TheZlodziej/keypad-board/kicad-project/ed_kicad_libraries/README.md

# Some of the most commonly used prefixes:
- C - capacitor
- D - diode (including LEDs!)
- J - header pins or 'jack' connector
- JP - jumper
- L - inductor
- M - motor
- Q - transistor/FETs
- R - resistor
- S - switch (TACT switch, etc.)
- TP - test point
- U - integrated circuit (sensors, MCUs, etc.)
- X - Wikipedia lists this last transducer, but it is often used to indicate connectors (USB, etc.)
- Y - Crystals or oscillators

> Source: https://learn.adafruit.com/ktowns-ultimate-creating-parts-in-eagle-tutorial/adding-a-name-prefix

Wrzucajcie źródła z któych korzystacie do sources, ale na schematch należy korzystać wyłącznie z naszych bilbilitek (prefix PUTRocketLab).
Chyba, że kopiujecie elementy z innych projektów eagle, do których nie dostępne są biblioteki.
