TheZlodziej/keypad-board/kicad-project/ed_kicad_libraries/Sources/BMM150_BGA_array.ods

 | x | y
E1 | -0.531 | 0.601
C1 | 0.035 | 0.601
A1 | 0.601 | 0.601
D2 | -0.248 | 0.318
B2 | 0.318 | 0.318
E3 | -0.531 | 0.035
A3 | 0.601 | 0.035
D4 | -0.248 | -0.248
B4 | 0.318 | -0.248
E5 | -0.531 | -0.531
C5 | 0.035 | -0.531
A5 | 0.601 | -0.531
