TheZlodziej/keypad-board/kicad-project/3d_models/asm_mx_asm_PLATE.stp

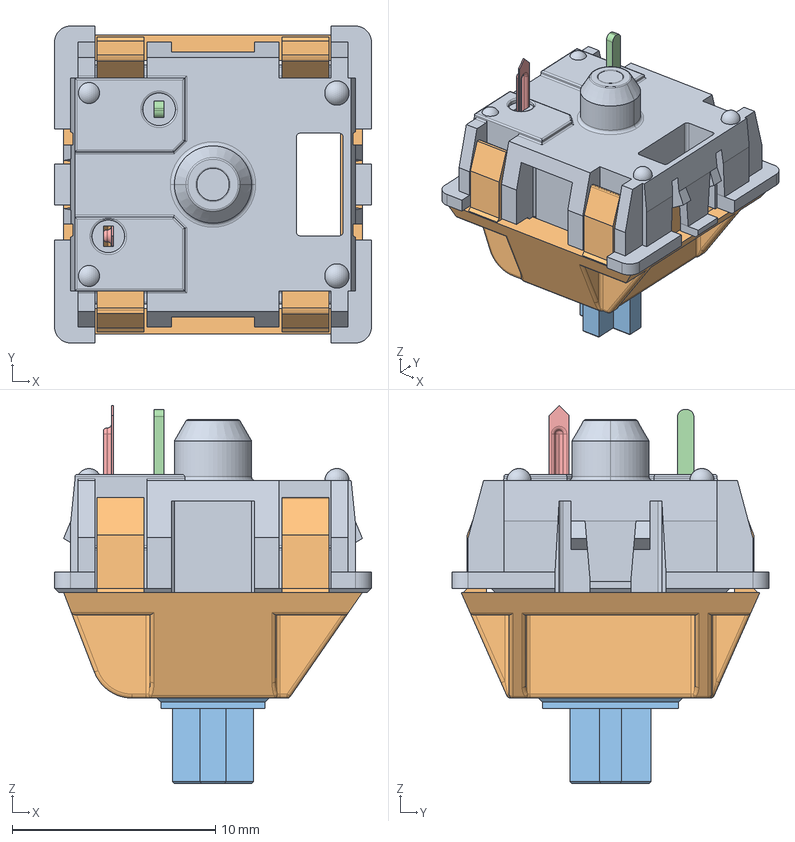
[picture p1: CAD file, 2023-11-23]
kicad-project/3d_models/asm_mx_asm_PLATE.stp
15.6 x 15.6 x 18.6 mm
MX_DOWN
MX_UP
UP_MX
MX_PIN
MX_SPRING
MX_CLICK
