TheZlodziej/keypad-board/kicad-project/3d_models/potentio_assem_asm.stp

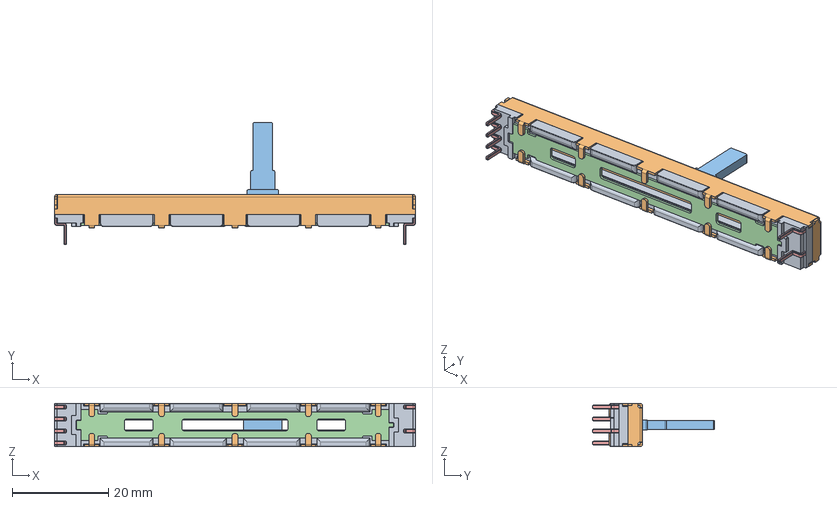
[picture p2: CAD file, 2023-11-23]
kicad-project/3d_models/potentio_assem_asm.stp
75.0 x 25.4 x 9.00 mm
SLIDE_POTENTIOMETER_BODY
SLIDE_POTENTIOMETER_COVER
SLIDE_POTENTIOMETER_BAR
SLIDE_POTENTIOMETER_PLATE
SLIDE_POTENTIOMETER_PIN x 6
