TheZlodziej/keypad-board/keypad-kicad-proj/keypad_cutout.dxf

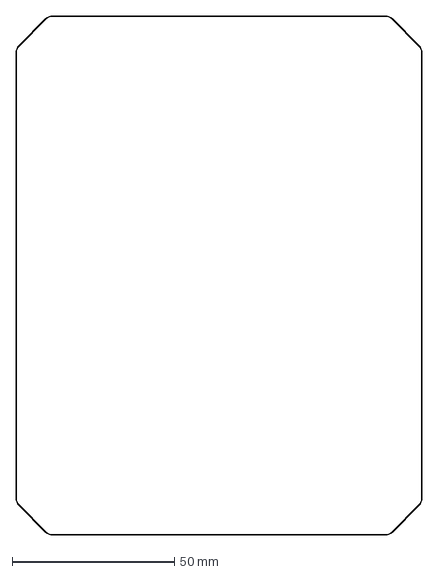
[picture p3: CAD file, 2023-11-23]
keypad-kicad-proj/keypad_cutout.dxf
125.0 x 160.0 mm
