TheZlodziej/keypad-board/kicad-project/ed_kicad_libraries/Sources/LIB_MAX-M10S-00B/MAX-M10S-00B/3D/MAX-M10S-00B.stp

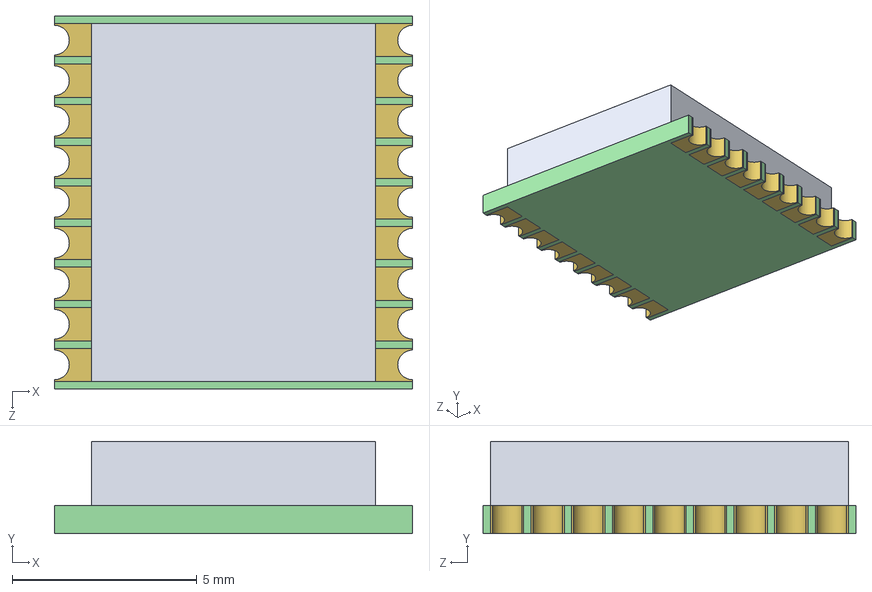
[picture p4: CAD file, 2023-11-23]
kicad-project/ed_kicad_libraries/Sources/LIB_MAX-M10S-00B/MAX-M10S-00B/3D/MAX-M10S-00B.stp
9.70 x 2.50 x 10.1 mm
