TheZlodziej/keypad-board/kicad-project/3d_models/Vertical slide switch SS-12D00G3 High Knob 3mm SPDT v2.step

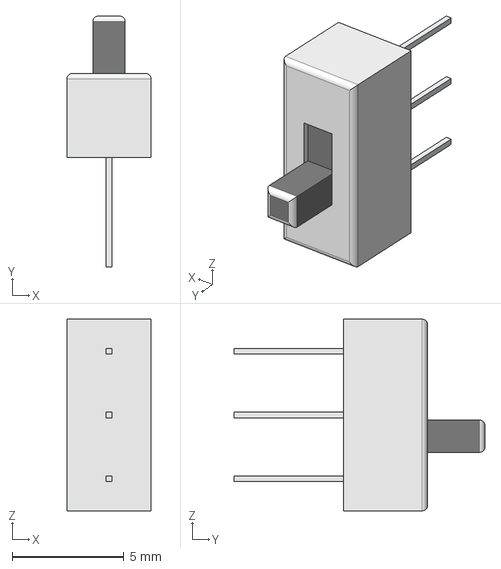
[picture p5: CAD file, 2023-11-23]
kicad-project/3d_models/Vertical slide switch SS-12D00G3 High Knob 3mm SPDT v2.step
3.77 x 11.2 x 8.59 mm
