TheZlodziej/keypad-board/kicad-project/3d_models/USB Type C Port (SMD Type).STEP

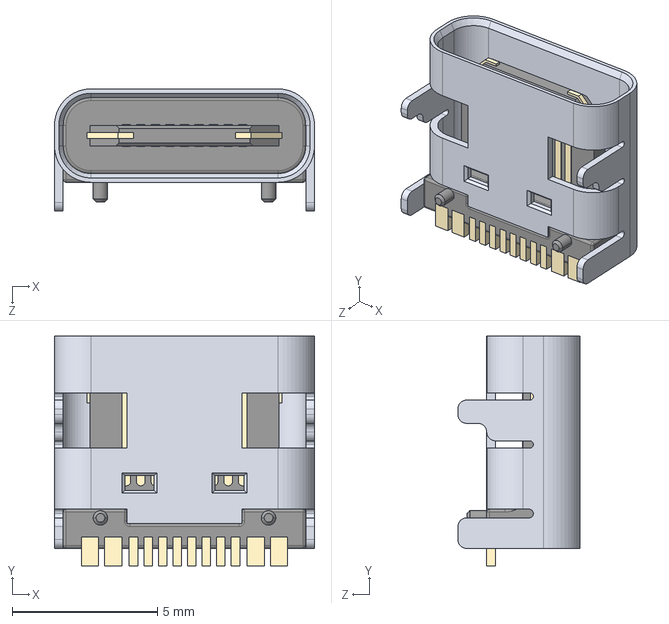
[picture p6: CAD file, 2023-11-23]
kicad-project/3d_models/USB Type C Port (SMD Type).STEP
8.94 x 7.90 x 4.20 mm
