TheZlodziej/keypad-board/kicad-project/3d_models/Buzzer_5V.STEP

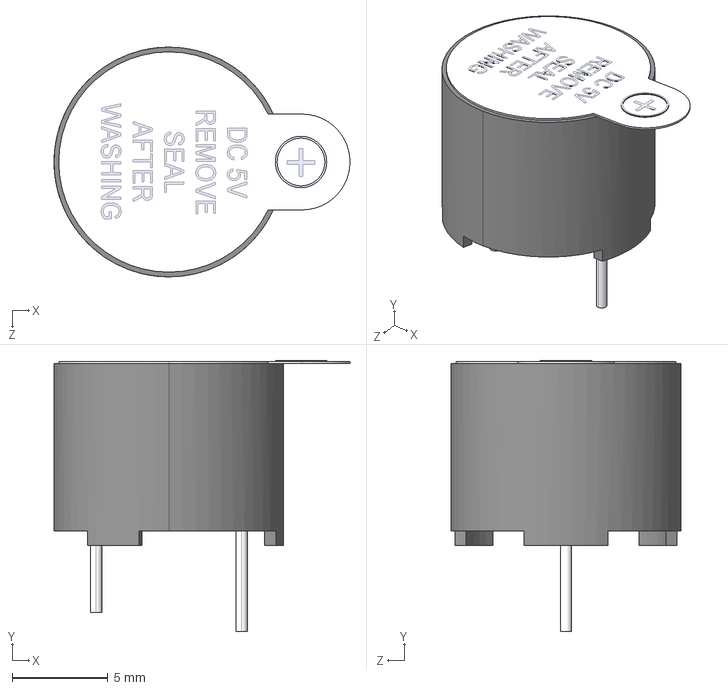
[picture p7: CAD file, 2023-11-23]
kicad-project/3d_models/Buzzer_5V.STEP
15.5 x 14.2 x 12.0 mm
