TheZlodziej/keypad-board/kicad-project/3d_models/Bourns_-_PEC11R-4220F-S0024.step

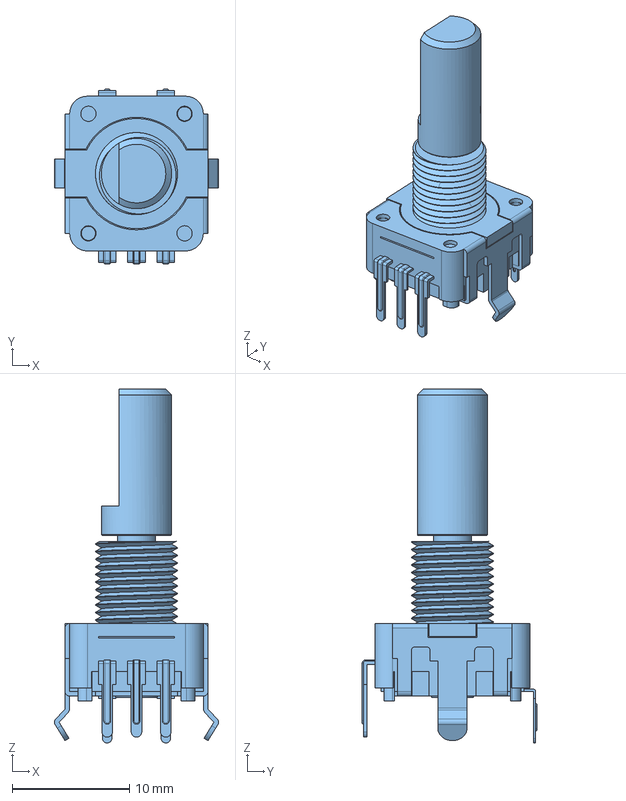
[picture p8: CAD file, 2023-11-23]
kicad-project/3d_models/Bourns_-_PEC11R-4220F-S0024.step
14.0 x 14.9 x 30.2 mm
