TheZlodziej/keypad-board/kicad-project/3d_models/mx_keycap.STEP

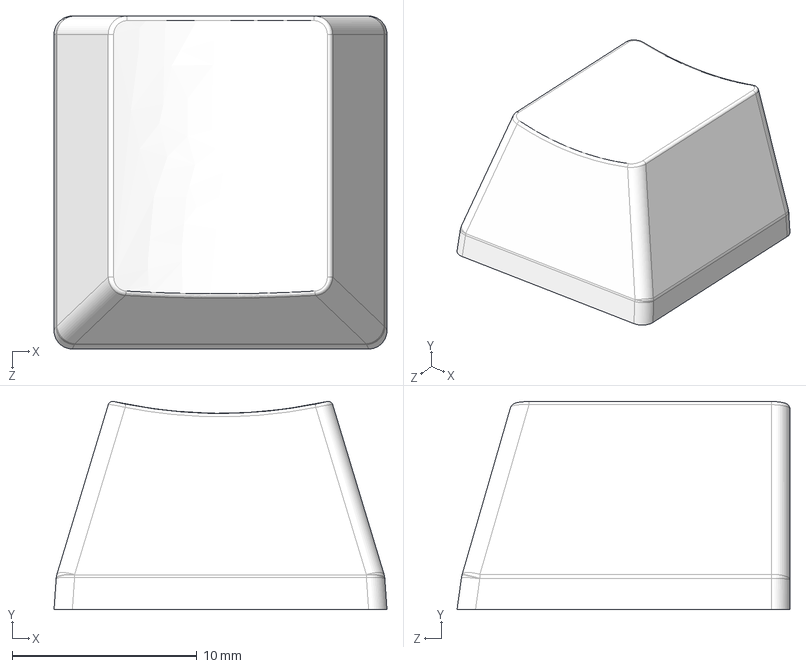
[picture p10: CAD file, 2023-11-23]
kicad-project/3d_models/mx_keycap.STEP
18.0 x 11.3 x 18.0 mm
