TheZlodziej/keypad-board/kicad-project/3d_models/EC12 Encoder 10mm 3pin.stp

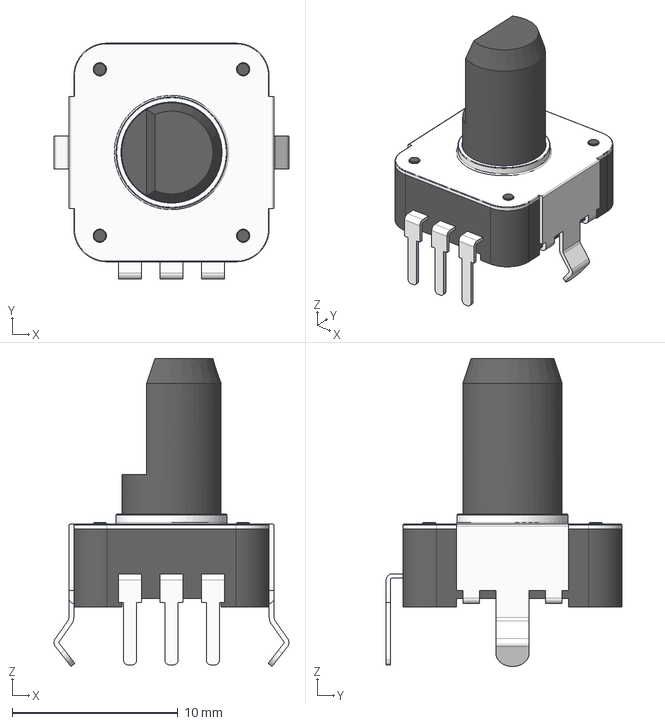
[picture p12: CAD file, 2023-11-23]
kicad-project/3d_models/EC12 Encoder 10mm 3pin.stp
14.2 x 14.2 x 18.6 mm
