TheZlodziej/keypad-board/(list of files, cad)

Other CAD files:
keypad-cover.ipt
kicad-project/ed_kicad_libraries/Sources/LIB_MAX-M10S-00B/MAX-M10S-00B/Allegro/maxm10s00b.psm
kicad-project/ed_kicad_libraries/Sources/LIB_MAX-M10S-00B/MAX-M10S-00B/DEHDL/max_m10s_00b/chips/chips.prt
