TheZlodziej/keypad-board/kicad-project/schematic.pdf

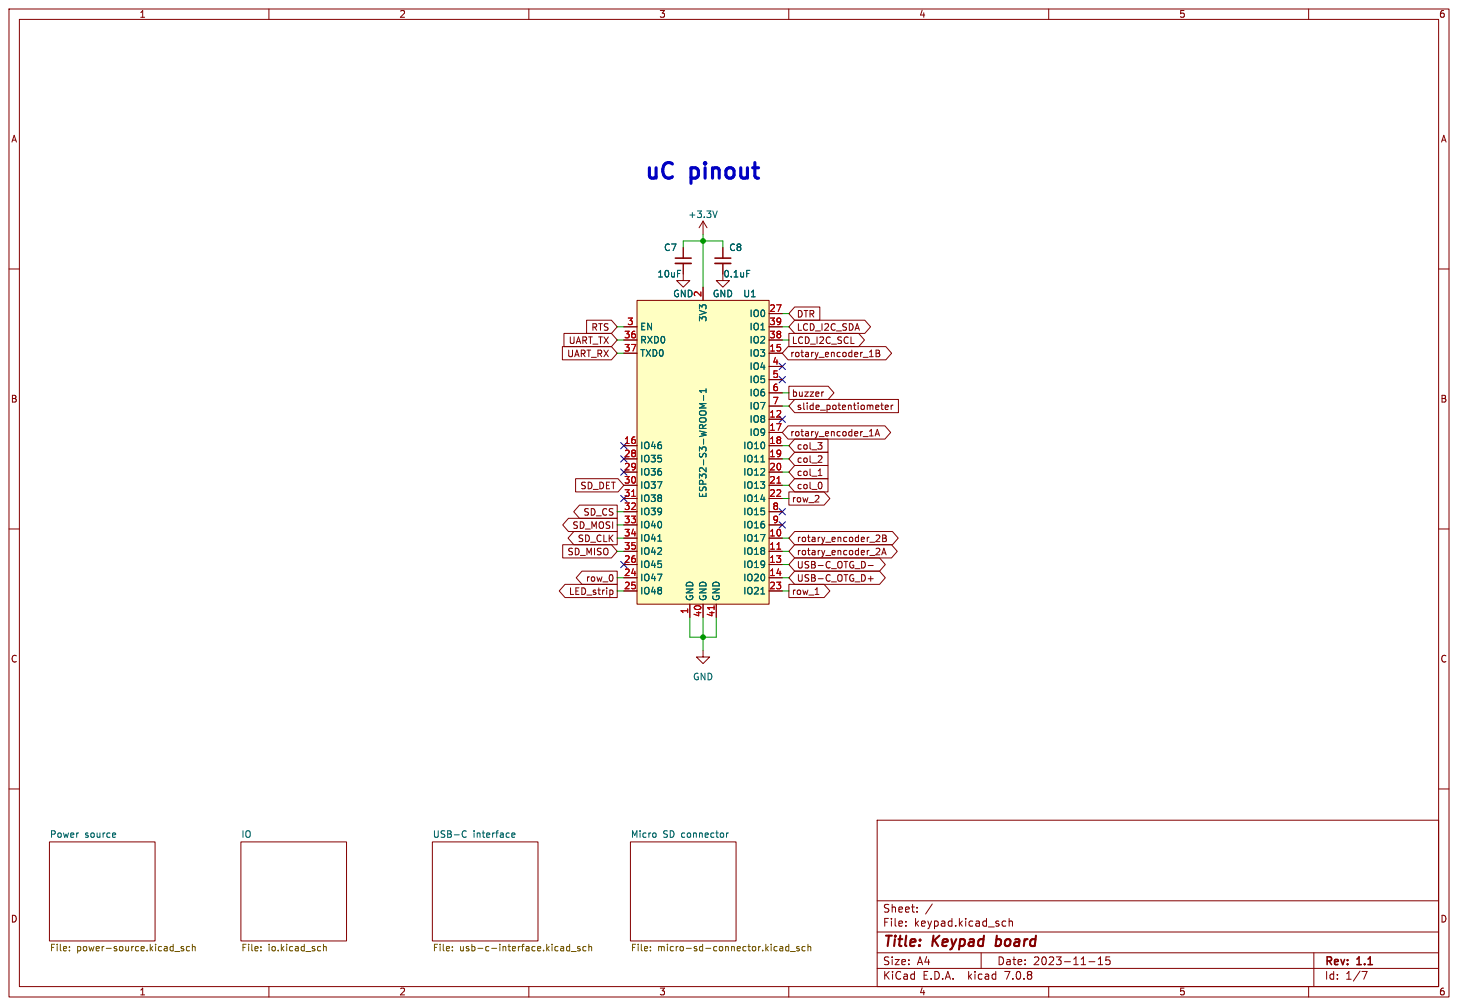
[picture p13: page 1]

File: keypad.kicad_sch Sheet: /
Id: 1/7 Title: Keypad board

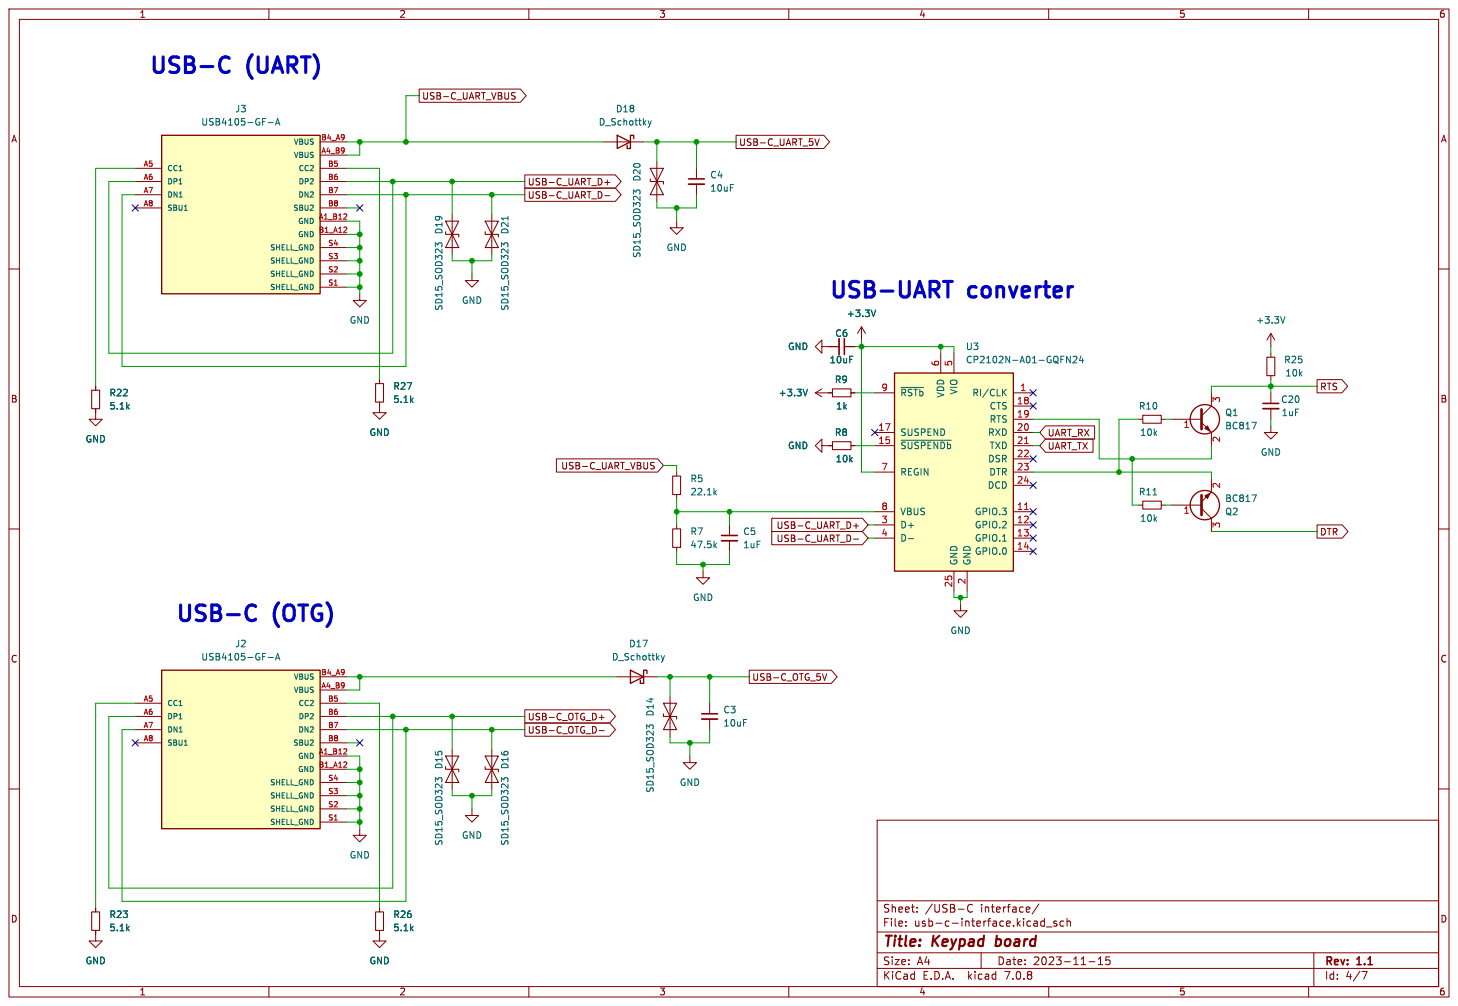
[picture p14: page 2]

2 RXD 20 TXD 21 DSR 22 DTR 23 DCD 24 GND 25 D+ 3 D- 4 VIO

Id: 4/7 Title: Keypad board

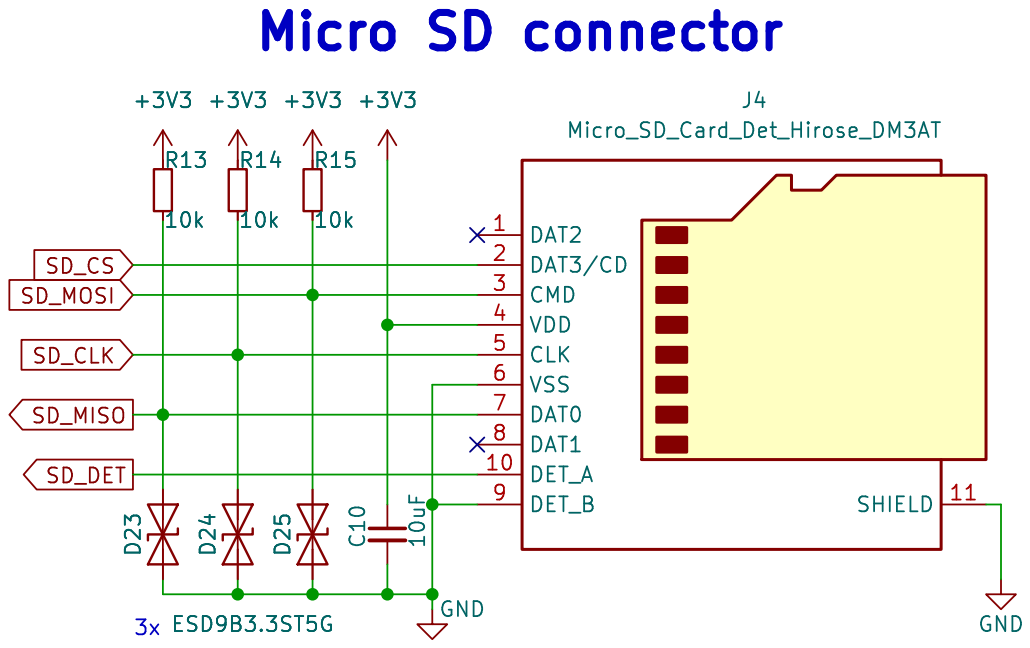
[picture p15: page 3]

Id: 5/7 Title: Keypad board

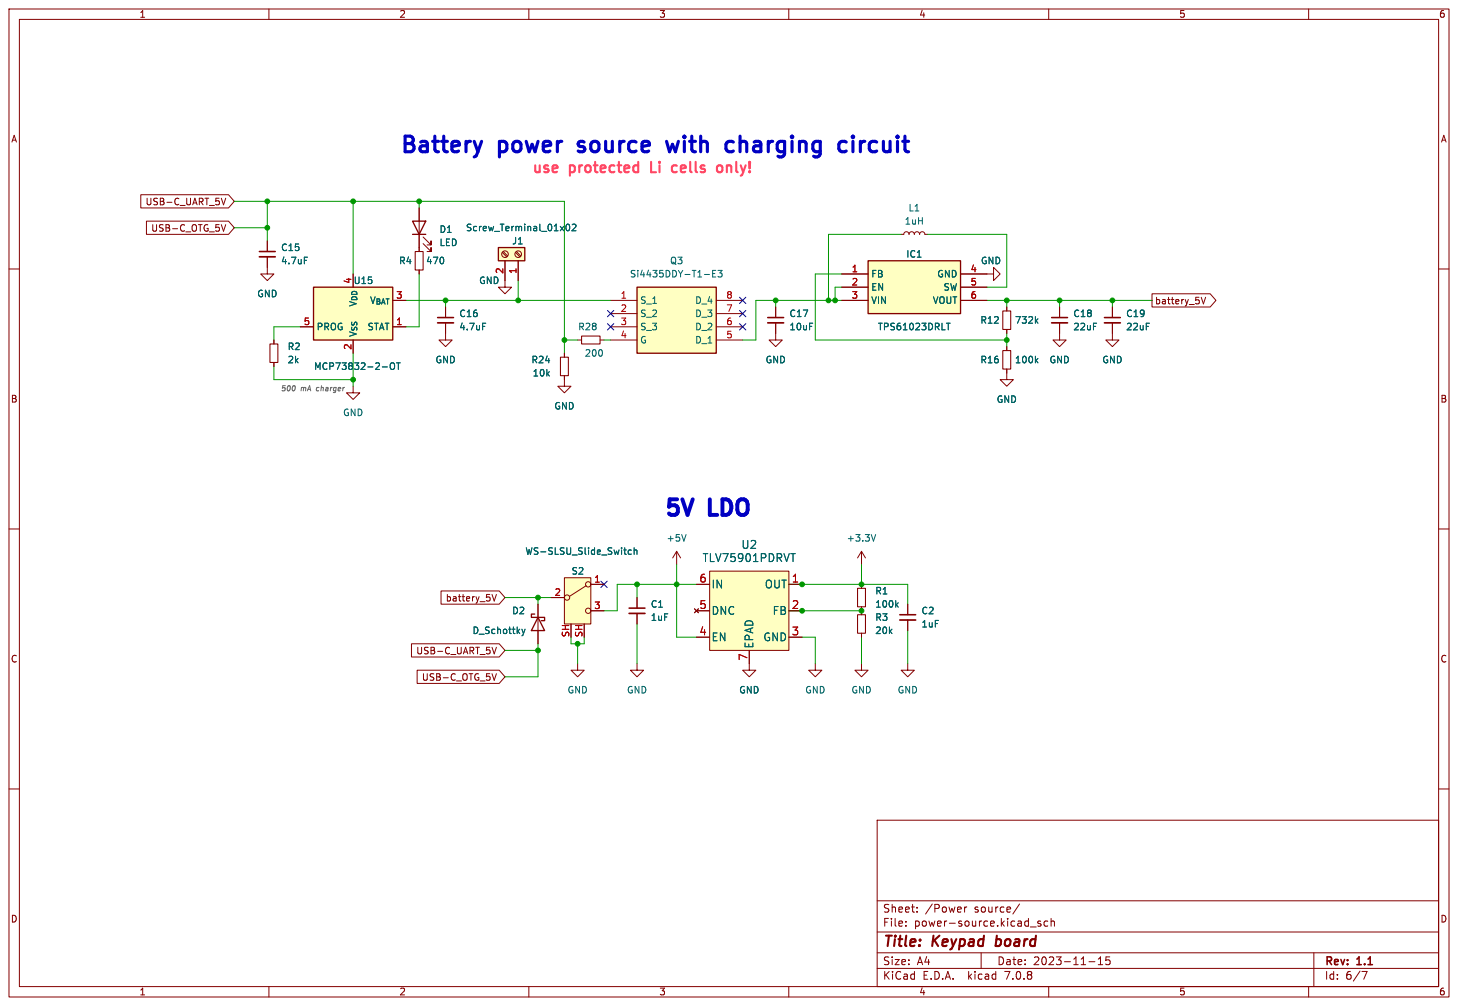
[picture p16: page 4]

Id: 6/7 Title: Keypad board

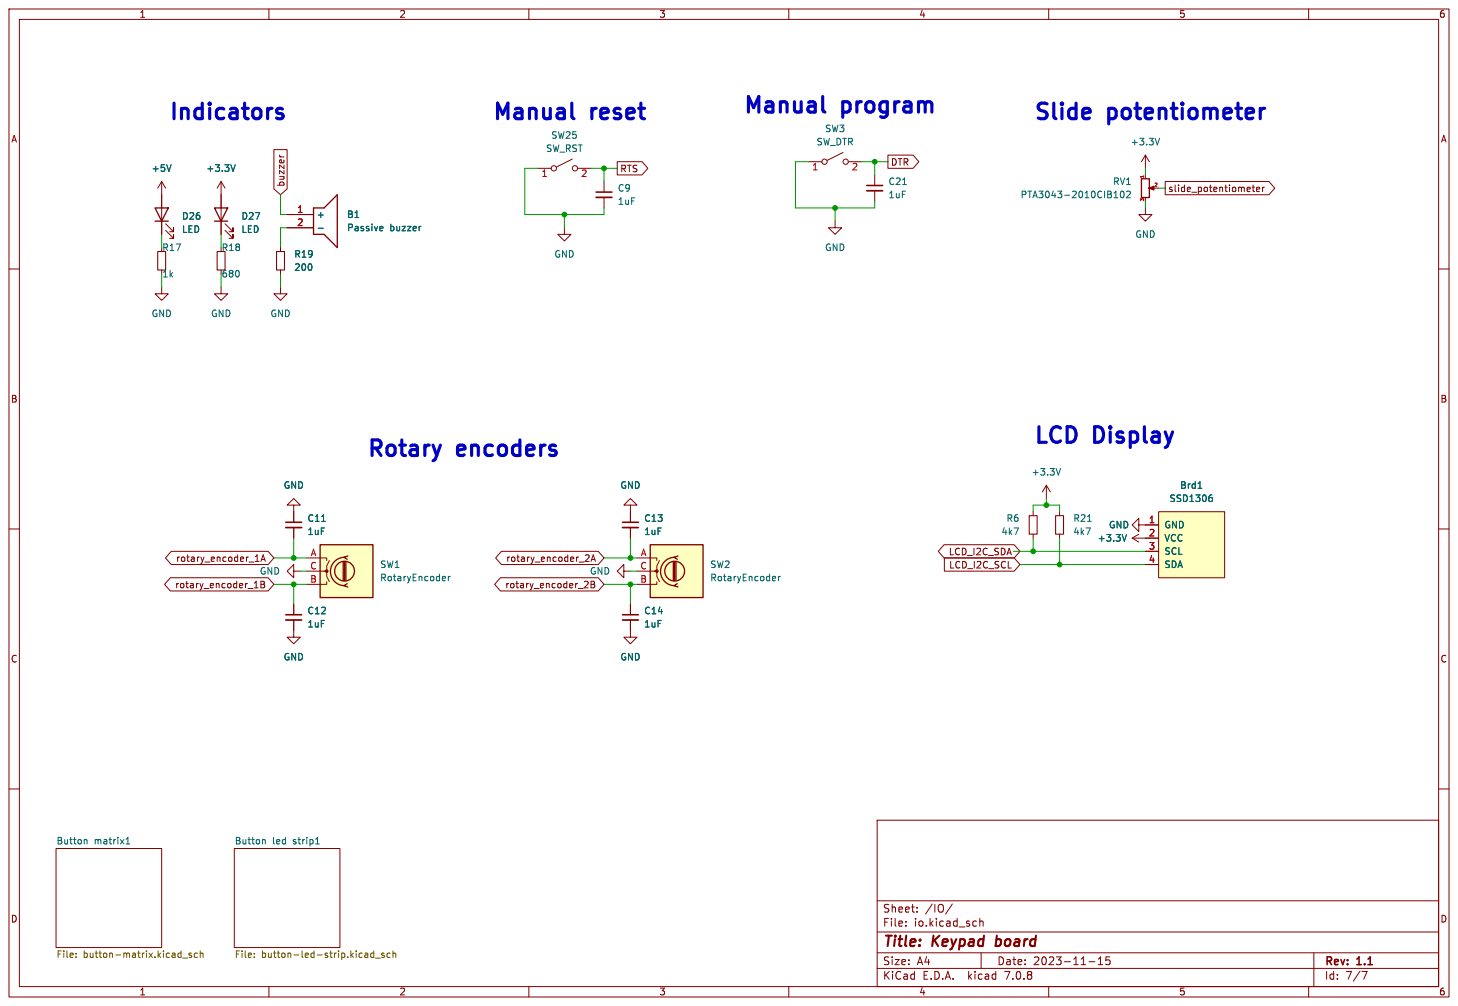
[picture p17: page 5]

Id: 7/7 Title: Keypad board

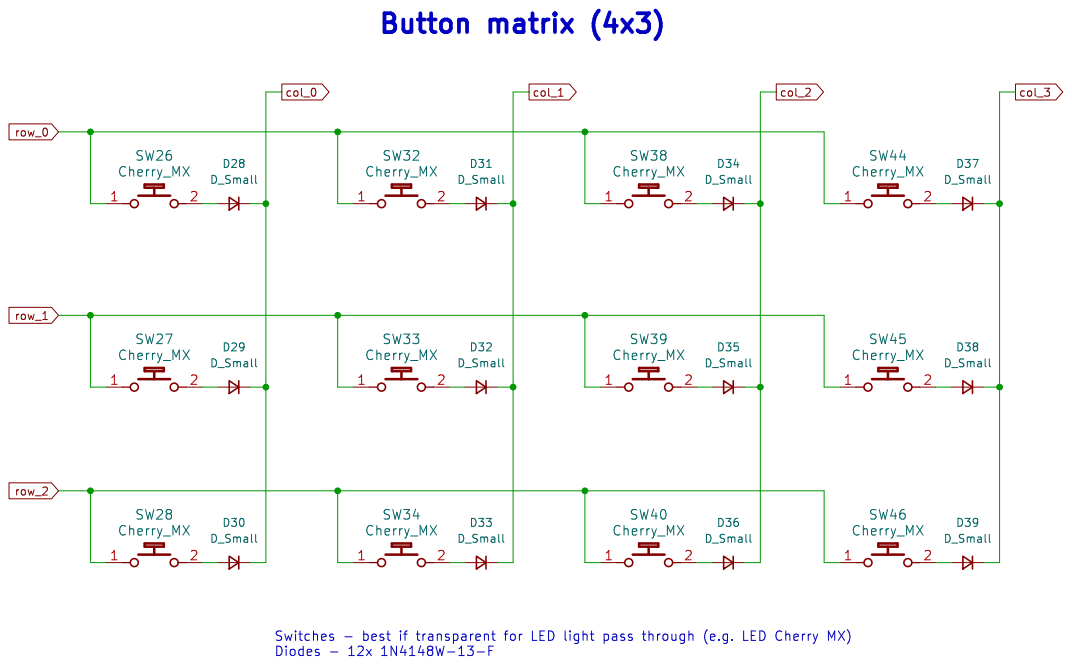
[picture p18: page 6]

Id: 8/7 Title: Keypad board

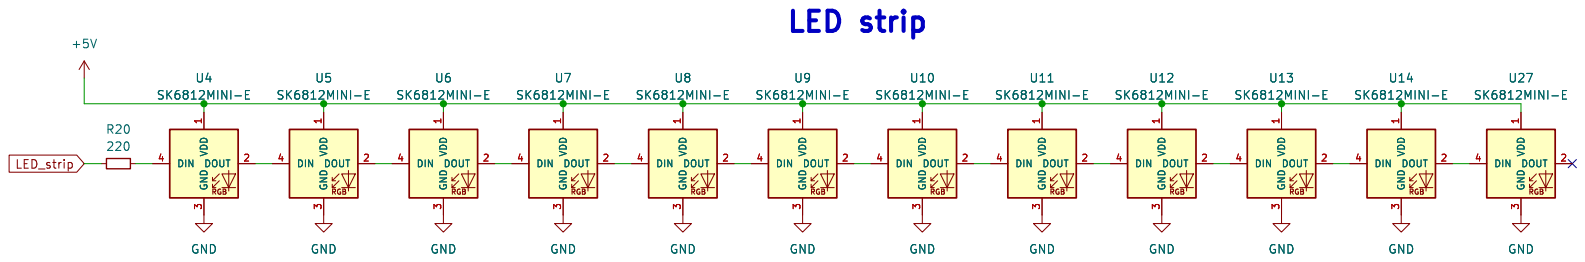
[picture p19: page 7]

3 DIN 4 U12 SK6812MINI-E GND GND GND

Id: 9/7 Title: Keypad board
