TheZlodziej/keypad-board/keypad-kicad-proj/keypad/keypad.kicad_pcb

## KiCad design keypad-kicad-proj/keypad/keypad.kicad_pcb (2023-11-23)

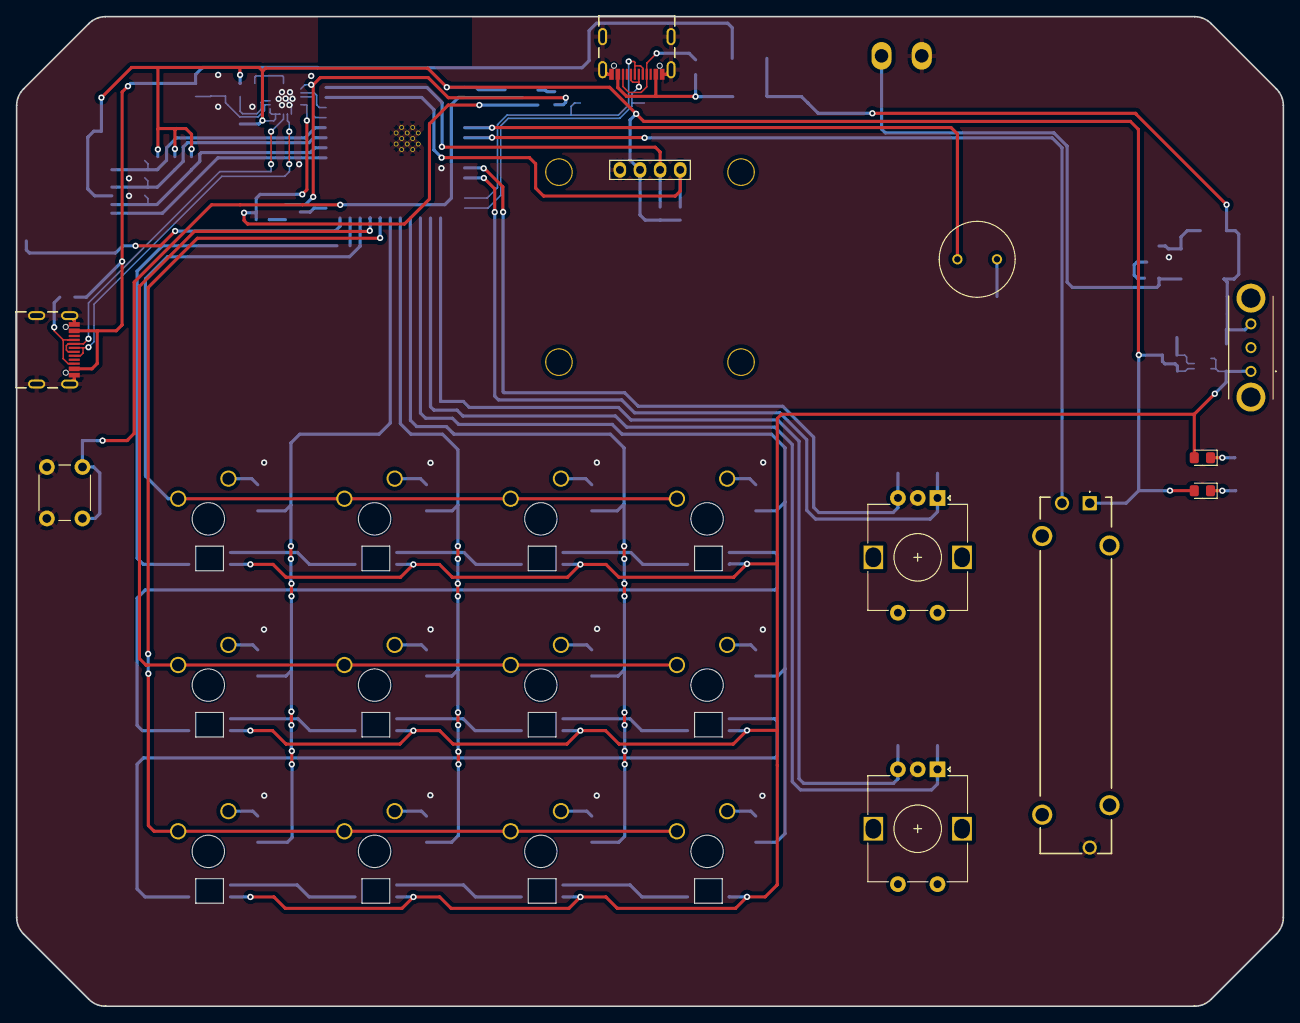
[picture p20: board keypad.kicad_pcb from above]

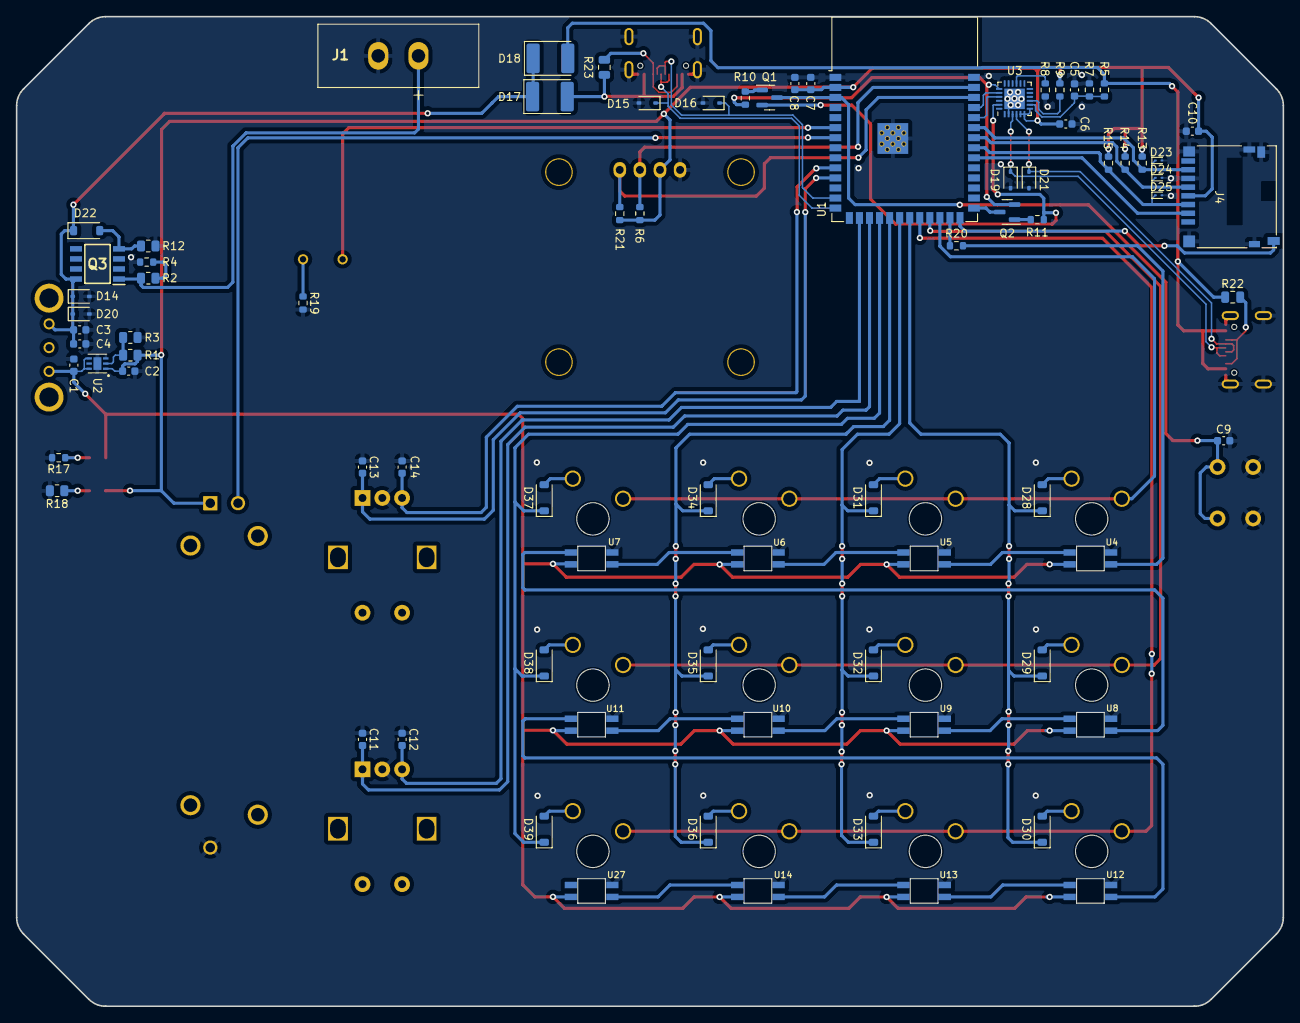
[picture p21: board keypad.kicad_pcb from below]

Board: 2 copper layers, 160.0 x 125.0 mm, 103 parts (80 on the bottom side), 75 nets.

Parts:
B1: Passive buzzer; CMI9605IC0580T
Brd1: SSD1306; 128x64OLED_V2
C1, C2, C5, C9, C11, C12, C13, C14: 1uF; C_0603_1608Metric
C3, C4, C6, C7, C10: 10uF; C_0603_1608Metric
C8: 0.1uF; C_0603_1608Metric
D14, D15, D16, D19, D20, D21: SD15_SOD323; D_SOD-323
D17, D18: D_Schottky; D_2114_3652Metric
D22, D28, D29, D30, D31, D32, D33, D34, D35, D36, D37, D38, D39: D_Small; D_SOD-123
D23, D24, D25: ESD9B3.3ST5G; D_SOD-923
D26, D27: LED; LED_0805_2012Metric_Pad1.15x1.40mm_HandSolder
J1: Screw_Terminal_01x02; XY2500R-DS(5.08)-02V
J2, J3: USB4105-GF-A; GCT_USB4105-GF-A
J4: Micro_SD_Card_Det_Hirose_DM3AT; microSD_HC_Hirose_DM3D-SF
Q1, Q2: BC817; SOT-23
Q3: IRF9393TRPBF; SOIC127P600X175-8N
R1, R12: 100k; R_0805_2012Metric
R2: 1M; R_0805_2012Metric
R3: 20k; R_0805_2012Metric
R4: 249k; R_0603_1608Metric
R5: 22.1k; R_0603_1608Metric
R6, R21: 4k7; R_0603_1608Metric
R7: 47.5k; R_0603_1608Metric
R8, R10, R11, R13, R14, R15: 10k; R_0603_1608Metric
R9, R17: 1k; R_0603_1608Metric
R18: 680; R_0805_2012Metric
R19: 200; R_0603_1608Metric
R20: 220; R_0603_1608Metric
R22, R23: 56k; C_0805_2012Metric
RV1: R_Potentiometer_Small; PTA30432010CIB102
S1: WS-SLSU_Slide_Switch; EG1206A
SW1, SW2: RotaryEncoder; RotaryEncoder_Alps_EC12E-Switch_Vertical_H20mm
SW25: SW_RST; SW_PUSH_6mm
SW26, SW27, SW28, SW32, SW33, SW34, SW38, SW39, SW40, SW44, SW45, SW46: Cherry_MX; MX1A-E1NW cherry mx blue rgb
U1: ESP32-S3-WROOM-1
U2: TLV75901PDRVT
U3: CP2102N-A01-GQFN24; QFN-24-1EP_4x4mm_P0.5mm_EP2.6x2.6mm
U4, U5, U6, U7, U8, U9, U10, U11, U12, U13, U14, U27: SK6812MINI-E

Connections:
+3V3: Brd1.2 (VCC), C2.1, C6.1, C7.1, C8.1, C10.1, D27.2 (A), J4.4 (VDD), R1.1, R6.1, R9.2, R13.1, R14.1, R15.1, R21.1, RV1.1, U1.2 (3V3), U2.1 (OUT), U3.5 (VIO), U3.6 (VDD), U3.7 (REGIN)
+5V: C1.1, D26.2 (A), S1.1, U2.4 (EN), U2.6 (IN), U4.1 (VDD), U5.1 (VDD), U6.1 (VDD), U7.1 (VDD), U8.1 (VDD), U9.1 (VDD), U10.1 (VDD), U11.1 (VDD), U12.1 (VDD), U13.1 (VDD), U14.1 (VDD), U27.1 (VDD)
DTR: Q2.3 (C), U1.27 (IO0)
GND: Brd1.1 (GND), C1.2, C2.2, C3.2, C4.2, C5.2, C6.2, C7.2, C8.2, C9.2, C10.2, C11.1, C12.2, C13.1, C14.2, D14.2 (A2), D15.2 (A2), D16.2 (A2), D19.2 (A2), D20.2 (A2), D21.2 (A2), D23.2 (A2), D24.2 (A2), D25.2 (A2), J1.2, J2.A1_B12 (GND), J2.B1_A12 (GND), J2.S1 (SHELL_GND), J2.S2 (SHELL_GND), J2.S3 (SHELL_GND), J2.S4 (SHELL_GND), J3.A1_B12 (GND), J3.B1_A12 (GND), J3.S1 (SHELL_GND), J3.S2 (SHELL_GND), J3.S3 (SHELL_GND), J3.S4 (SHELL_GND), J4.6 (VSS), J4.9 (DET_B), J4.11 (SHIELD), R3.2, R4.2, R7.2, R8.2, R12.2, R17.2, R18.2, R19.2, RV1.3, SW1.C, SW2.C, SW25.1 (A), U1.1 (GND), U1.40 (GND), U1.41 (GND), U2.3 (GND), U2.7 (EPAD), U3.2 (GND), U3.25 (GND), U4.3 (GND), U5.3 (GND), U6.3 (GND), U7.3 (GND), U8.3 (GND), U9.3 (GND), U10.3 (GND), U11.3 (GND), U12.3 (GND), U13.3 (GND), U14.3 (GND), U27.3 (GND)
LCD_I2C_SCL: Brd1.4 (SDA), R21.2, U1.38 (IO2)
LCD_I2C_SDA: Brd1.3 (SCL), R6.2, U1.39 (IO1)
LED_strip: R20.2, U1.25 (IO48)
unnamed: B1.2 (-), R19.1
unnamed: D17.2 (A), J2.A4_B9 (VBUS), J2.B4_A9 (VBUS), R23.1
unnamed: D22.2 (A), Q3.4 (G), R12.1
unnamed: D26.1 (K), R17.1
unnamed: D27.1 (K), R18.1
unnamed: D28.2 (A), SW26.2
unnamed: D29.2 (A), SW27.2
unnamed: D30.2 (A), SW28.2
unnamed: D31.2 (A), SW32.2
unnamed: D32.2 (A), SW33.2
unnamed: D33.2 (A), SW34.2
unnamed: D34.2 (A), SW38.2
unnamed: D35.2 (A), SW39.2
unnamed: D36.2 (A), SW40.2
unnamed: D37.2 (A), SW44.2
unnamed: D38.2 (A), SW45.2
unnamed: D39.2 (A), SW46.2
unnamed: J1.1, Q3.1 (S_1), R2.1
unnamed: J2.A5 (CC1), J2.B5 (CC2), R23.2
unnamed: J3.A5 (CC1), J3.B5 (CC2), R22.2
unnamed: Q1.1 (B), R10.1
unnamed: Q1.2 (E), R11.2, U3.23 (DTR)
unnamed: Q2.1 (B), R11.1
unnamed: Q2.2 (E), R10.2, U3.19 (RTS)
unnamed: R1.2, R3.1, U2.2 (FB)
unnamed: C5.1, R5.2, R7.1, U3.8 (VBUS)
unnamed: R9.1, U3.9 (~RSTb)
unnamed: R8.1, U3.15 (~SUSPENDb)
unnamed: R20.1, U4.4 (DIN)
unnamed: U4.2 (DOUT), U5.4 (DIN)
unnamed: U5.2 (DOUT), U6.4 (DIN)
unnamed: U6.2 (DOUT), U7.4 (DIN)
unnamed: U7.2 (DOUT), U8.4 (DIN)
unnamed: U8.2 (DOUT), U9.4 (DIN)
unnamed: U9.2 (DOUT), U10.4 (DIN)
unnamed: U10.2 (DOUT), U11.4 (DIN)
unnamed: U11.2 (DOUT), U12.4 (DIN)
unnamed: U12.2 (DOUT), U13.4 (DIN)
unnamed: U13.2 (DOUT), U14.4 (DIN)
unnamed: U14.2 (DOUT), U27.4 (DIN)
RTS: C9.1, Q1.3 (C), SW25.2 (B), U1.3 (EN)
SD_CLK: D24.1 (A1), J4.5 (CLK), R14.2, U1.34 (IO41)
SD_CS: J4.2 (DAT3/CD), U1.32 (IO39)
SD_DET: J4.10 (DET_A), U1.26 (IO45)
SD_MISO: D23.1 (A1), J4.7 (DAT0), R13.2, U1.35 (IO42)
SD_MOSI: D25.1 (A1), J4.3 (CMD), R15.2, U1.33 (IO40)
UART_RX: U1.37 (TXD0), U3.20 (RXD)
UART_TX: U1.36 (RXD0), U3.21 (TXD)
USB-C_OTG_5V: C3.1, C4.1, D14.1 (A1), D17.1 (K), D18.1 (K), D20.1 (A1), D22.1 (K), Q3.8 (D_4), S1.3
USB-C_OTG_D+: D15.1 (A1), J2.A6 (DP1), J2.B6 (DP2), U1.14 (IO20)
USB-C_OTG_D-: D16.1 (A1), J2.A7 (DN1), J2.B7 (DN2), U1.13 (IO19)
USB-C_UART_D+: D19.1 (A1), J3.A6 (DP1), J3.B6 (DP2), U3.3 (D+)
USB-C_UART_D-: D21.1 (A1), J3.A7 (DN1), J3.B7 (DN2), U3.4 (D-)
USB-C_UART_VBUS: D18.2 (A), J3.A4_B9 (VBUS), J3.B4_A9 (VBUS), R5.1, R22.1
battery_test: R2.2, R4.1
buzzer: B1.1 (+), U1.6 (IO6)
col_0: D28.1 (K), D29.1 (K), D30.1 (K), U1.21 (IO13)
col_1: D31.1 (K), D32.1 (K), D33.1 (K), U1.20 (IO12)
col_2: D34.1 (K), D35.1 (K), D36.1 (K), U1.19 (IO11)
col_3: D37.1 (K), D38.1 (K), D39.1 (K), U1.18 (IO10)
rotary_encoder_1A: C11.2, SW1.A, U1.17 (IO9)
rotary_encoder_1B: C12.1, SW1.B, U1.16 (IO46)
rotary_encoder_2A: C13.2, SW2.A, U1.11 (IO18)
rotary_encoder_2B: C14.1, SW2.B, U1.10 (IO17)
row_0: SW26.1, SW32.1, SW38.1, SW44.1, U1.24 (IO47)
row_1: SW27.1, SW33.1, SW39.1, SW45.1, U1.23 (IO21)
row_2: SW28.1, SW34.1, SW40.1, SW46.1, U1.22 (IO14)
slide_potentiometer: RV1.2, U1.7 (IO7)
