TheZlodziej/keypad-board/kicad-project/keypad/button-led-strip.kicad_sch

## KiCad design kicad-project/keypad/button-led-strip.kicad_sch (2023-12-01)

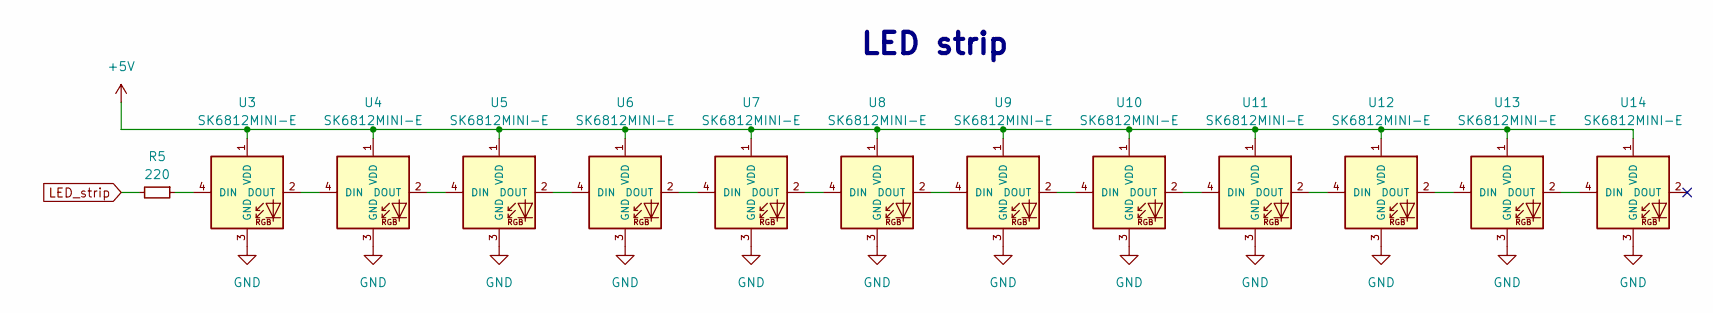
[picture p22: schematic button-led-strip.kicad_sch]

Parts:
R5: 220; R_0603_1608Metric
U3, U4, U5, U6, U7, U8, U9, U10, U11, U12, U13, U14: SK6812MINI-E

Connections:
+5V: U3.1 (VDD), U4.1 (VDD), U5.1 (VDD), U6.1 (VDD), U7.1 (VDD), U8.1 (VDD), U9.1 (VDD), U10.1 (VDD), U11.1 (VDD), U12.1 (VDD), U13.1 (VDD), U14.1 (VDD)
GND: U3.3 (GND), U4.3 (GND), U5.3 (GND), U6.3 (GND), U7.3 (GND), U8.3 (GND), U9.3 (GND), U10.3 (GND), U11.3 (GND), U12.3 (GND), U13.3 (GND), U14.3 (GND)
LED_strip: R5.2
unnamed: R5.1, U3.4 (DIN)
unnamed: U3.2 (DOUT), U4.4 (DIN)
unnamed: U4.2 (DOUT), U5.4 (DIN)
unnamed: U5.2 (DOUT), U6.4 (DIN)
unnamed: U6.2 (DOUT), U7.4 (DIN)
unnamed: U7.2 (DOUT), U8.4 (DIN)
unnamed: U8.2 (DOUT), U9.4 (DIN)
unnamed: U10.2 (DOUT), U11.4 (DIN)
unnamed: U9.2 (DOUT), U10.4 (DIN)
unnamed: U11.2 (DOUT), U12.4 (DIN)
unnamed: U12.2 (DOUT), U13.4 (DIN)
unnamed: U13.2 (DOUT), U14.4 (DIN)

Notes on the sheet:
LED strip
