TheZlodziej/keypad-board/kicad-project/keypad/button-matrix.kicad_sch

## KiCad design kicad-project/keypad/button-matrix.kicad_sch (2023-12-29)

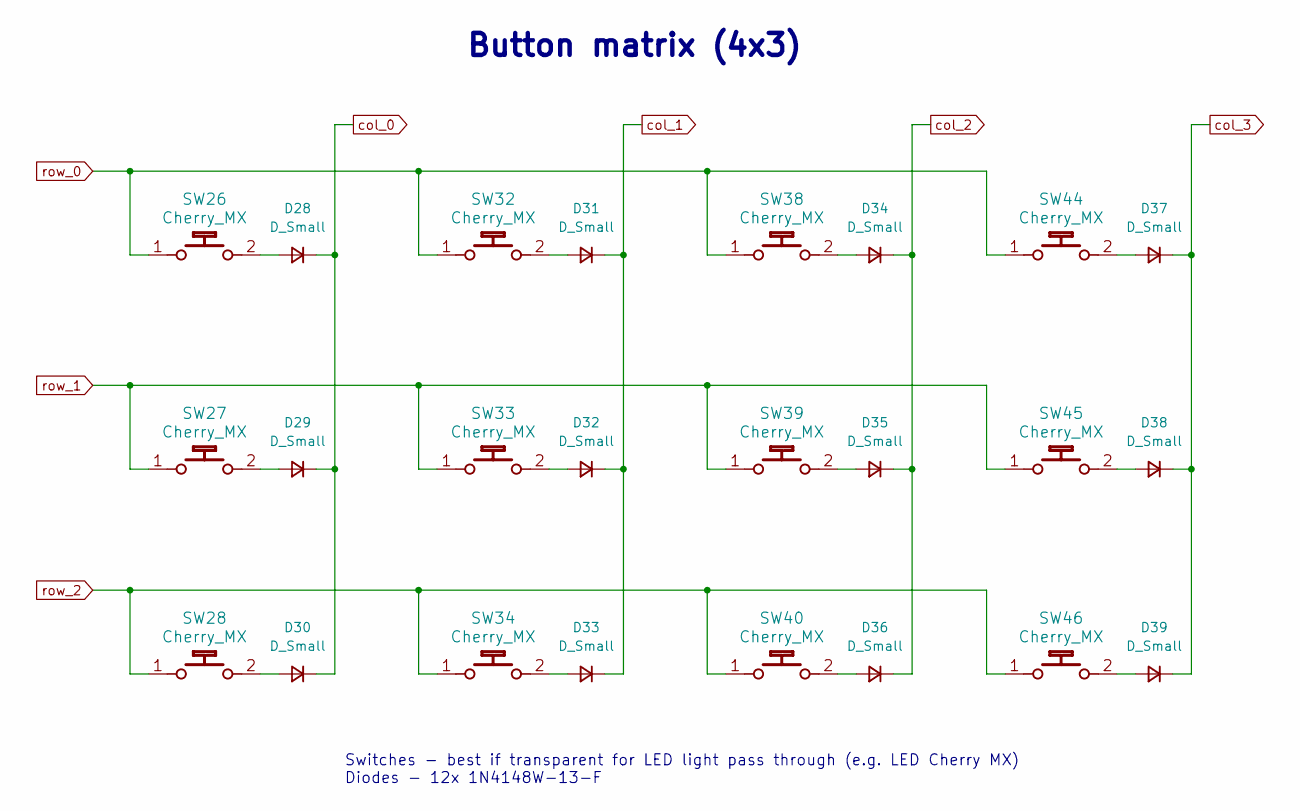
[picture p23: schematic button-matrix.kicad_sch]

Parts:
D28, D29, D30, D31, D32, D33, D34, D35, D36, D37, D38, D39: D_Small; D_SOD-323_HandSoldering
SW26, SW27, SW28, SW32, SW33, SW34, SW38, SW39, SW40, SW44, SW45, SW46: Cherry_MX; MX1A-E1NW cherry mx blue rgb

Connections:
unnamed: D28.2 (A), SW26.2
unnamed: D29.2 (A), SW27.2
unnamed: D30.2 (A), SW28.2
unnamed: D31.2 (A), SW32.2
unnamed: D32.2 (A), SW33.2
unnamed: D33.2 (A), SW34.2
unnamed: D34.2 (A), SW38.2
unnamed: D35.2 (A), SW39.2
unnamed: D36.2 (A), SW40.2
unnamed: D37.2 (A), SW44.2
unnamed: D38.2 (A), SW45.2
unnamed: D39.2 (A), SW46.2
col_0: D28.1 (K), D29.1 (K), D30.1 (K)
col_1: D31.1 (K), D32.1 (K), D33.1 (K)
col_2: D34.1 (K), D35.1 (K), D36.1 (K)
col_3: D37.1 (K), D38.1 (K), D39.1 (K)
row_0: SW26.1, SW32.1, SW38.1, SW44.1
row_1: SW27.1, SW33.1, SW39.1, SW45.1
row_2: SW28.1, SW34.1, SW40.1, SW46.1

Notes on the sheet:
Switches - best if transparent for LED light pass through (e.g. LED Cherry MX) Diodes - 12x 1N4148W-13-F
Button matrix (4x3)
