TheZlodziej/keypad-board/kicad-project/keypad/io.kicad_sch

## KiCad design kicad-project/keypad/io.kicad_sch (2024-01-02)

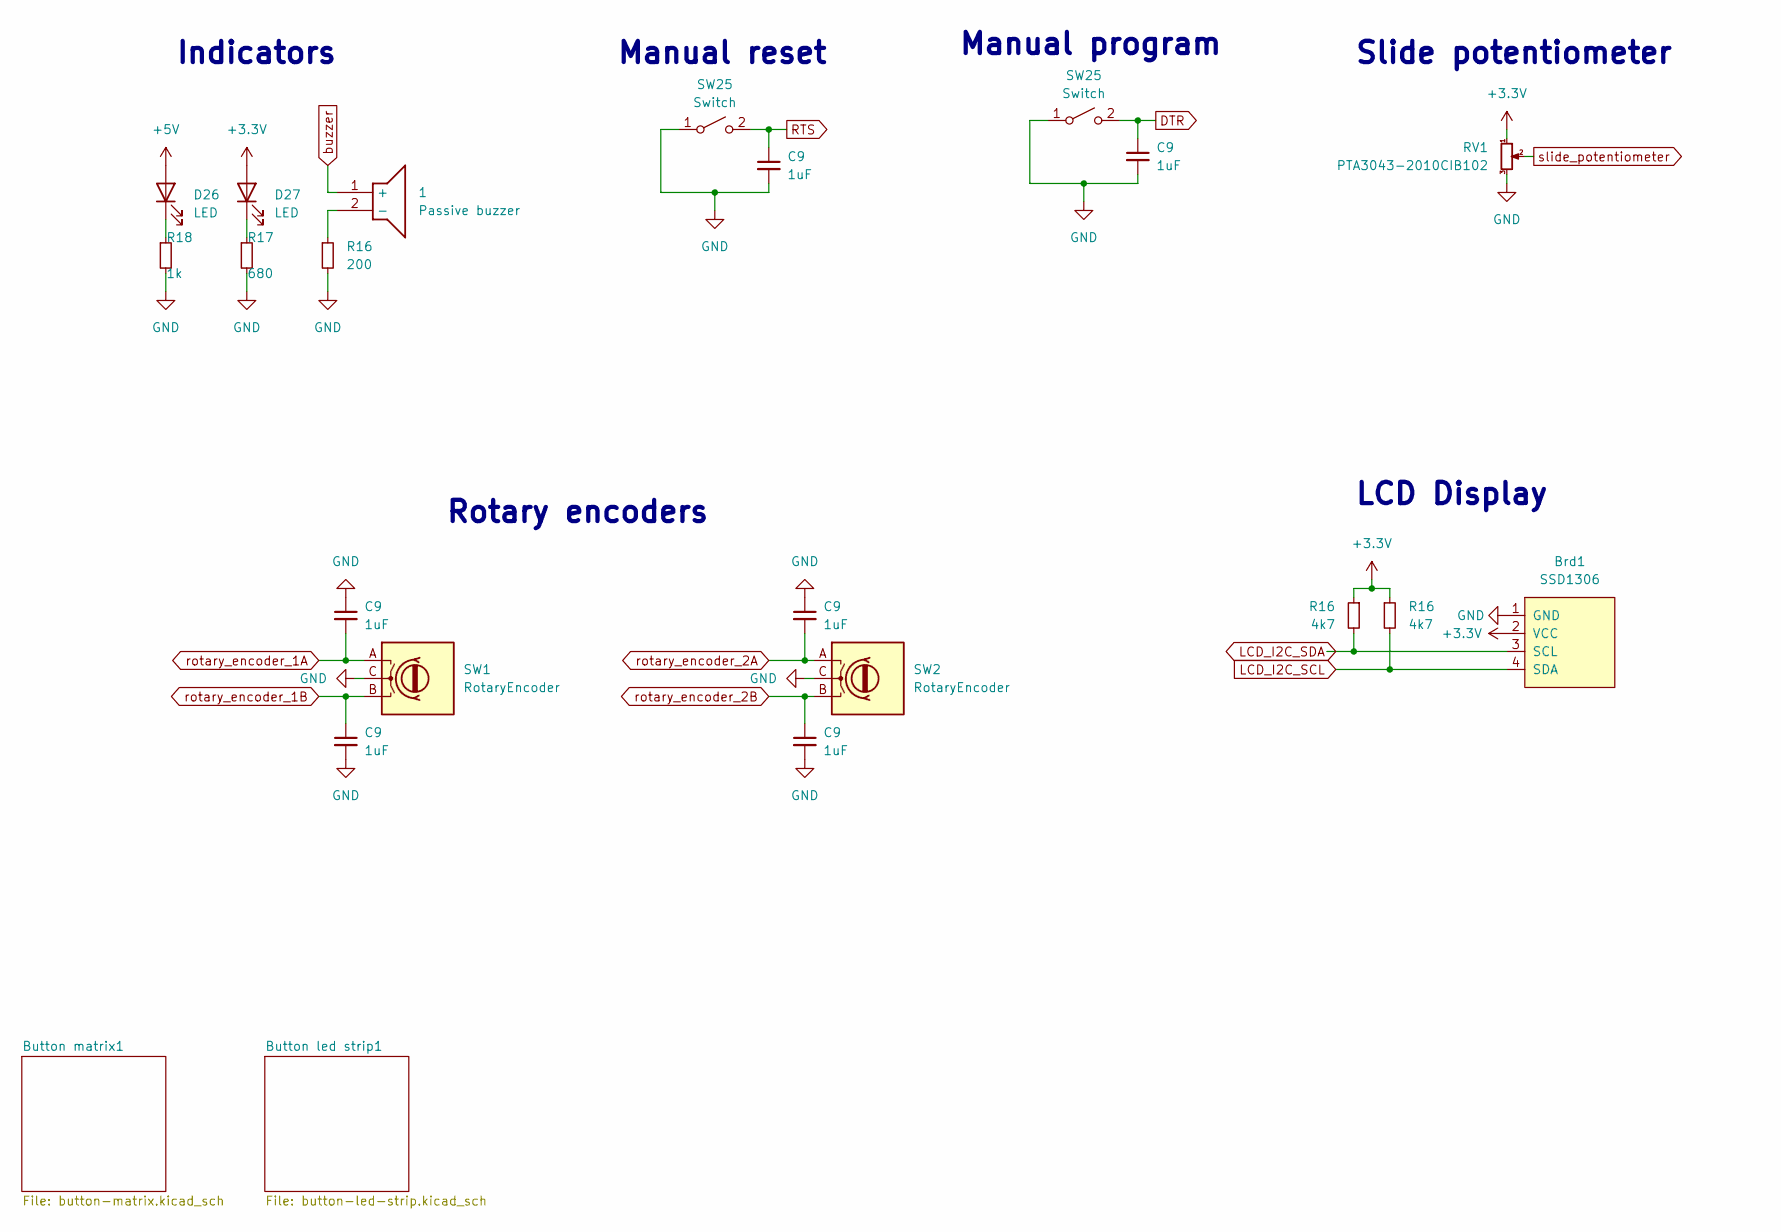
[picture p24: schematic io.kicad_sch]

Parts:
1: Passive buzzer; CMI9605IC0580T; Mouser Part Number 490-CMI-9605IC-0580T
Brd1: SSD1306; 128x64OLED_V2
C9: 1uF; C_0603_1608Metric_Pad1.08x0.95mm_HandSolder
D26, D27: LED; LED_0805_2012Metric_Pad1.15x1.40mm_HandSolder
R16: 200; R_0603_1608Metric
R17: 680; R_0805_2012Metric
R18: 1k; R_0603_1608Metric
RV1: PTA3043-2010CIB102; PTA30432010CIB102
SW1, SW2: RotaryEncoder; RotaryEncoder_Alps_EC12E-Switch_Vertical_H20mm
SW25: Switch; SW_PUSH_6mm

Connections:
+3.3V: Brd1.2 (VCC), D27.2 (A), R16.1, RV1.1
+5V: D26.2 (A)
DTR: C9.1, SW25.2 (B)
GND: Brd1.1 (GND), C9.1, C9.2, R16.2, R17.2, R18.2, RV1.3, SW1.C, SW2.C, SW25.1 (A)
LCD_I2C_SCL: Brd1.4 (SDA), R16.2
LCD_I2C_SDA: Brd1.3 (SCL), R16.2
unnamed: 1.2 (-), R16.1
unnamed: D26.1 (K), R18.1
unnamed: D27.1 (K), R17.1
RTS: C9.1, SW25.2 (B)
buzzer: 1.1 (+)
rotary_encoder_1A: C9.2, SW1.A
rotary_encoder_1B: C9.1, SW1.B
rotary_encoder_2A: C9.2, SW2.A
rotary_encoder_2B: C9.1, SW2.B
slide_potentiometer: RV1.2

Notes on the sheet:
Rotary encoders
Slide potentiometer
Indicators
Manual reset
LCD Display
Manual program
