TheZlodziej/keypad-board/kicad-project/keypad/keypad.kicad_sch

## KiCad design kicad-project/keypad/keypad.kicad_sch (2024-01-02)

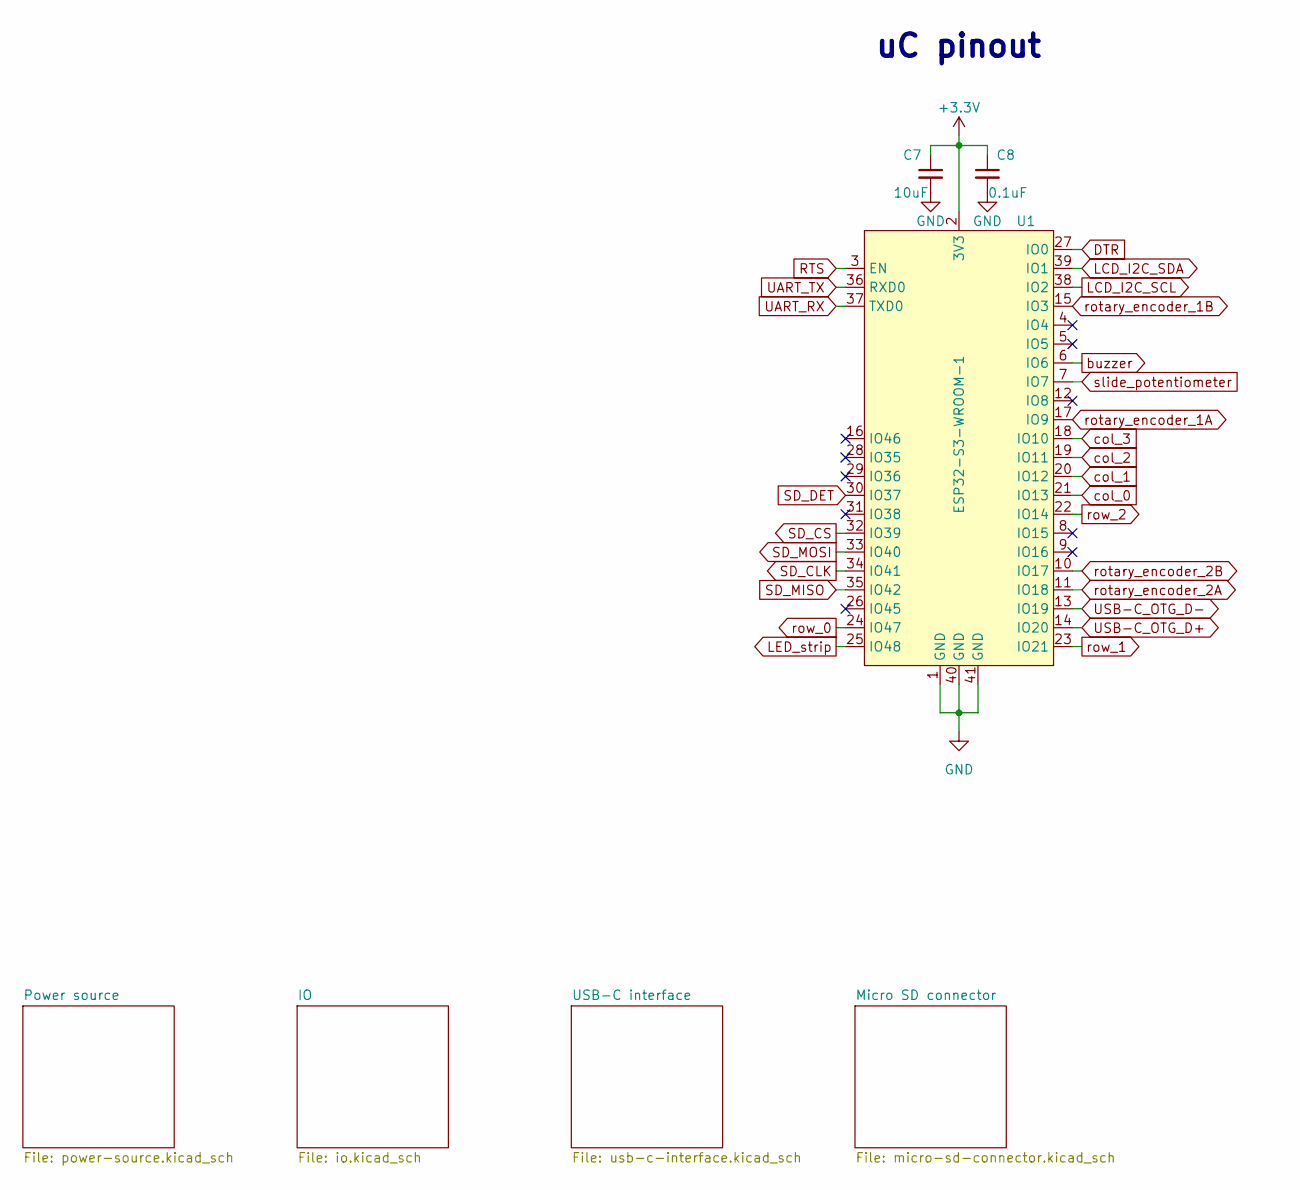
[picture p25: schematic keypad.kicad_sch]

Parts:
C7: 10uF; C_0603_1608Metric_Pad1.08x0.95mm_HandSolder
C8: 0.1uF; C_0603_1608Metric_Pad1.08x0.95mm_HandSolder
U1: ESP32-S3-WROOM-1

Connections:
+3.3V: C7.1, C8.1, U1.2 (3V3)
DTR: U1.27 (IO0)
GND: C7.2, C8.2, U1.1 (GND), U1.40 (GND), U1.41 (GND)
LCD_I2C_SCL: U1.38 (IO2)
LCD_I2C_SDA: U1.39 (IO1)
LED_strip: U1.25 (IO48)
RTS: U1.3 (EN)
SD_CLK: U1.34 (IO41)
SD_CS: U1.32 (IO39)
SD_DET: U1.30 (IO37)
SD_MISO: U1.35 (IO42)
SD_MOSI: U1.33 (IO40)
UART_RX: U1.37 (TXD0)
UART_TX: U1.36 (RXD0)
USB-C_OTG_D+: U1.14 (IO20)
USB-C_OTG_D-: U1.13 (IO19)
buzzer: U1.6 (IO6)
col_0: U1.21 (IO13)
col_1: U1.20 (IO12)
col_2: U1.19 (IO11)
col_3: U1.18 (IO10)
rotary_encoder_1A: U1.17 (IO9)
rotary_encoder_1B: U1.15 (IO3)
rotary_encoder_2A: U1.11 (IO18)
rotary_encoder_2B: U1.10 (IO17)
row_0: U1.24 (IO47)
row_1: U1.23 (IO21)
row_2: U1.22 (IO14)
slide_potentiometer: U1.7 (IO7)

Notes on the sheet:
uC pinout
