TheZlodziej/keypad-board/kicad-project/keypad/micro-sd-connector.kicad_sch

## KiCad design kicad-project/keypad/micro-sd-connector.kicad_sch (2024-01-02)

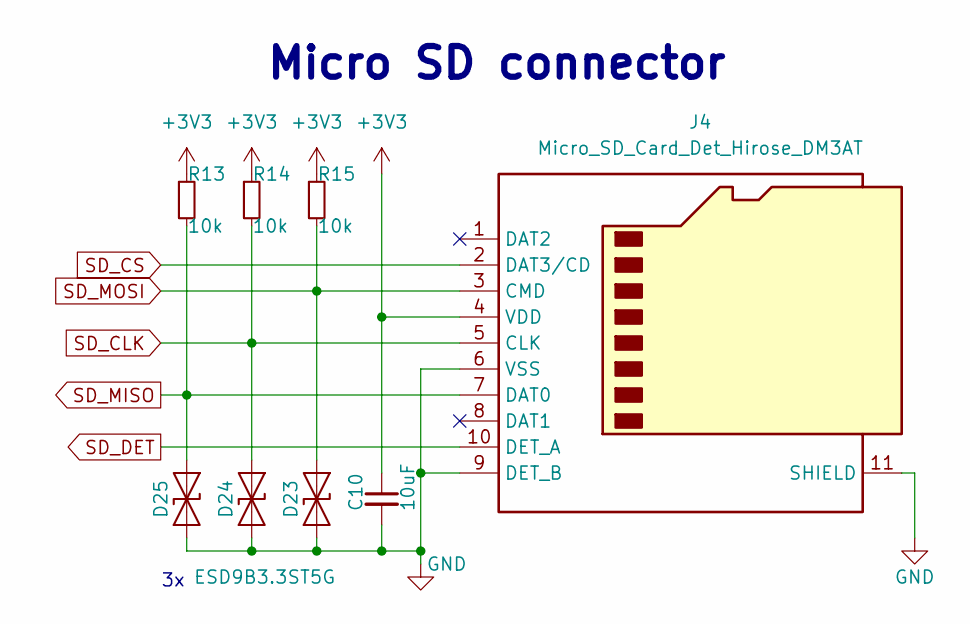
[picture p26: schematic micro-sd-connector.kicad_sch]

Parts:
C10: 10uF; C_0603_1608Metric_Pad1.08x0.95mm_HandSolder
D23, D24, D25: ESD9B3.3ST5G; D_SOD-923
J4: Micro_SD_Card_Det_Hirose_DM3AT; microSD_HC_Hirose_DM3D-SF
R13, R14, R15: 10k; R_0603_1608Metric

Connections:
+3V3: C10.1, J4.4 (VDD), R13.1, R14.1, R15.1
GND: C10.2, D23.2 (A2), D24.2 (A2), D25.2 (A2), J4.6 (VSS), J4.9 (DET_B), J4.11 (SHIELD)
SD_CLK: D24.1 (A1), J4.5 (CLK), R14.2
SD_CS: J4.2 (DAT3/CD)
SD_DET: J4.10 (DET_A)
SD_MISO: D25.1 (A1), J4.7 (DAT0), R13.2
SD_MOSI: D23.1 (A1), J4.3 (CMD), R15.2

Notes on the sheet:
Micro SD connector
