TheZlodziej/keypad-board/kicad-project/keypad/power-source.kicad_sch

## KiCad design kicad-project/keypad/power-source.kicad_sch (2024-01-02)

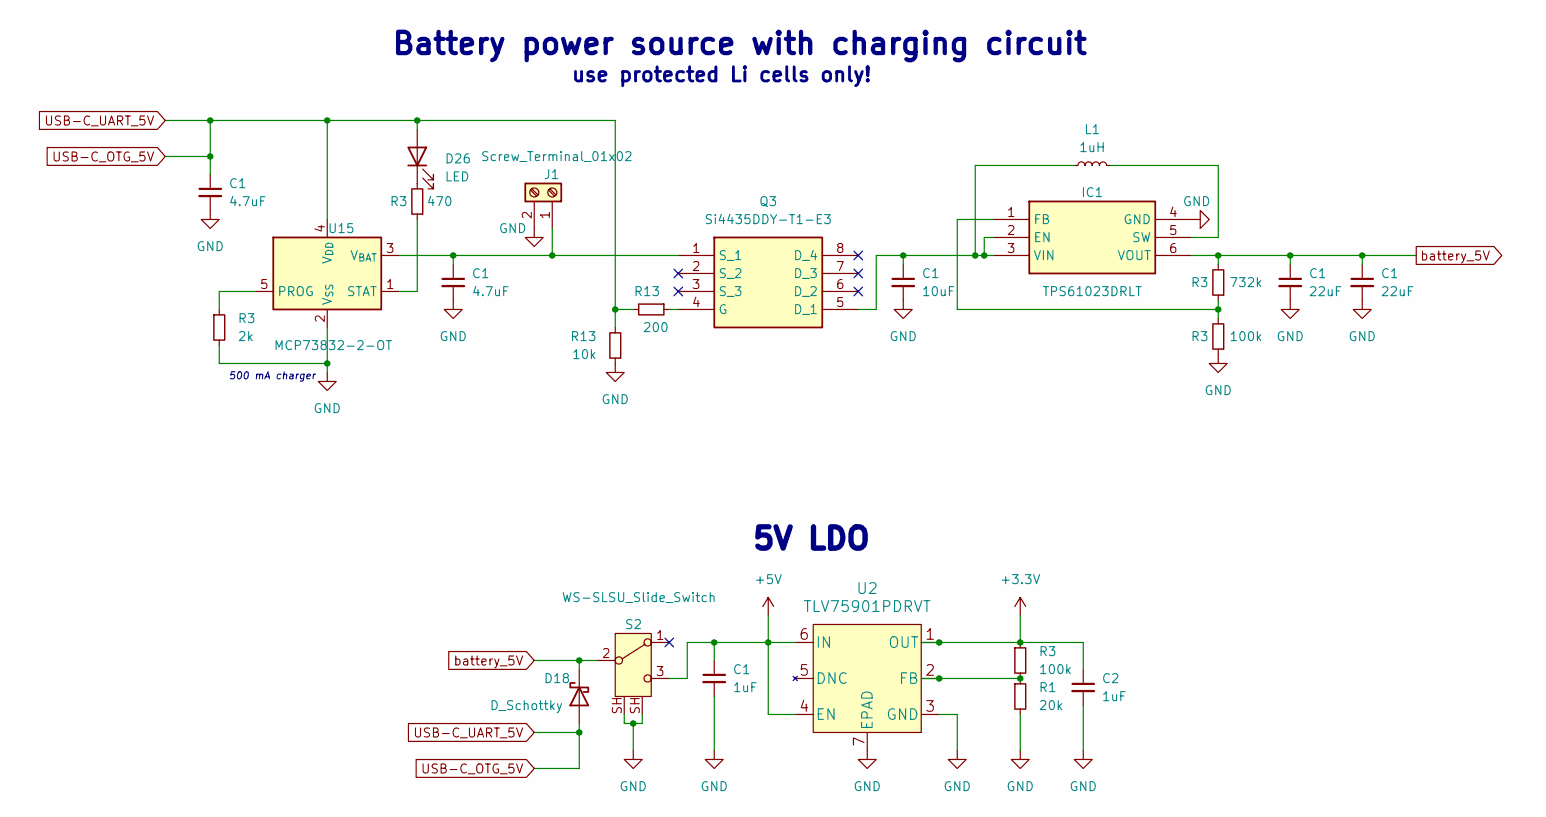
[picture p27: schematic power-source.kicad_sch]

Parts:
C1, C2: 1uF; C_0603_1608Metric_Pad1.08x0.95mm_HandSolder
D18: D_Schottky; D_2114_3652Metric
D26: LED; LED_0805_2012Metric_Pad1.15x1.40mm_HandSolder
IC1: TPS61023DRLT; TPS61023; Mouser Part Number 595-TPS61023DRLT
J1: Screw_Terminal_01x02; XY2500R-DS(5.08)-02V
L1: 1uH; INDPM5752X200N
Q3: Si4435DDY-T1-E3; SOIC127P600X175-8N; Manufacturer_Part_Number Si4435DDY-T1-E3; Mouser Part Number 781-SI4435DDY-T1-E3
R1: 20k; R_0805_2012Metric
R3: 470; R_0805_2012Metric
R13: 200; R_0603_1608Metric
S2: WS-SLSU_Slide_Switch; EG1206A
U2: TLV75901PDRVT
U15: MCP73832-2-OT; SOT-23-5

Connections:
+3.3V: C2.1, R3.1, U2.1 (OUT)
+5V: C1.1, S2.3, U2.4 (EN), U2.6 (IN)
GND: C1.2, C2.2, IC1.4 (GND), J1.2, R1.2, R3.1, R3.2, R13.1, S2.SH, U2.3 (GND), U2.7 (EPAD), U15.2 (V_{SS})
unnamed: C1.1, IC1.2 (EN), IC1.3 (VIN), J1.1, L1.1, Q3.1 (S_1), Q3.5 (D_1), U15.3 (V_{BAT})
unnamed: D26.1 (K), R3.2
unnamed: IC1.1 (FB), R3.1, R3.2
unnamed: IC1.5 (SW), L1.2
unnamed: Q3.4 (G), R13.1
unnamed: R1.1, R3.2, U2.2 (FB)
unnamed: R3.1, U15.1 (STAT), U15.5 (PROG)
USB-C_OTG_5V: C1.1, D18.2 (A), D26.2 (A), R13.2, U15.4 (V_{DD})
battery_5V: C1.1, D18.1 (K), IC1.6 (VOUT), R3.2, S2.2

Notes on the sheet:
use protected Li cells only!
Battery power source with charging circuit
5V LDO
500 mA charger
