TheZlodziej/keypad-board/kicad-project/keypad/usb-c-interface.kicad_sch

## KiCad design kicad-project/keypad/usb-c-interface.kicad_sch (2024-01-02)

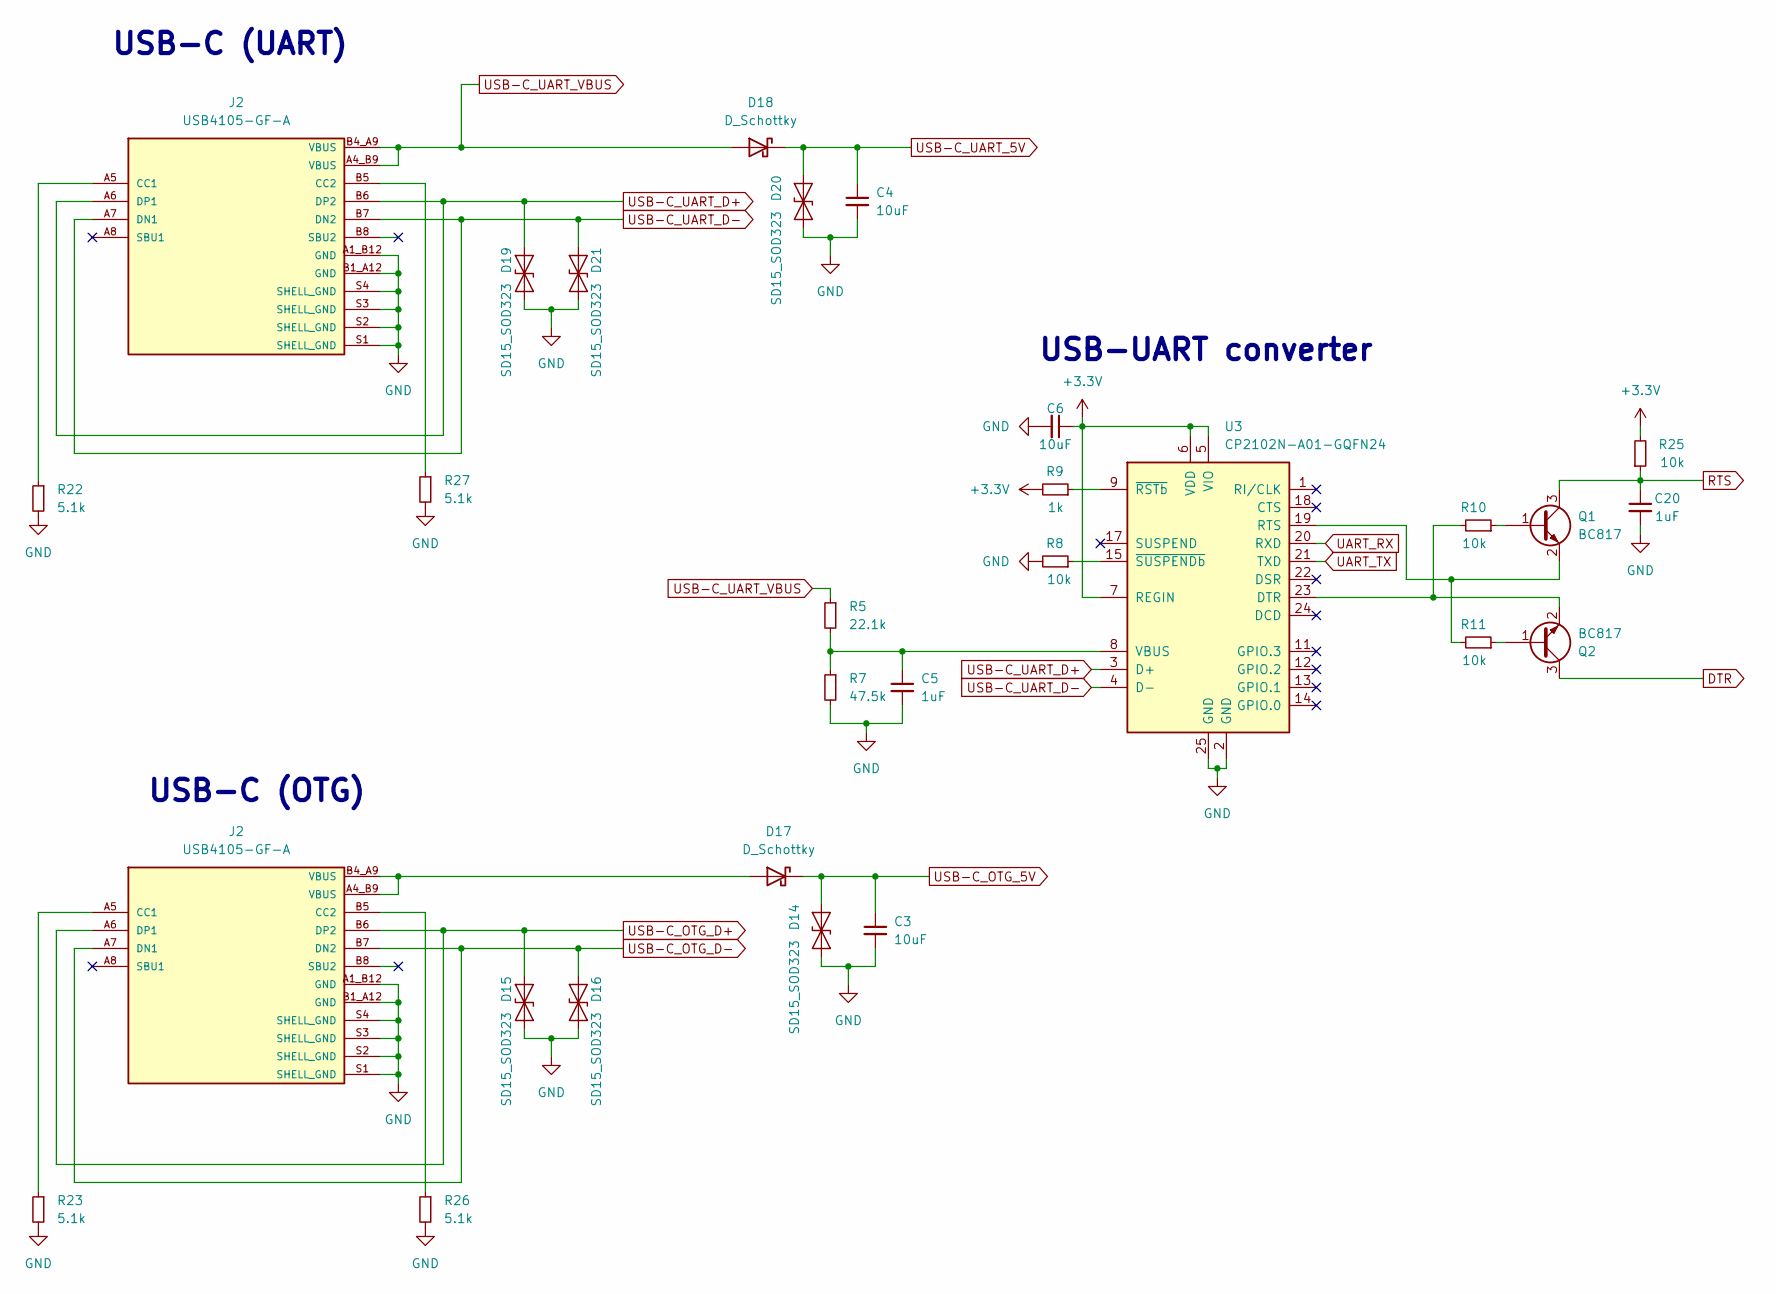
[picture p28: schematic usb-c-interface.kicad_sch]

Parts:
C3, C4, C6: 10uF; C_0603_1608Metric_Pad1.08x0.95mm_HandSolder
C5, C20: 1uF; C_0603_1608Metric_Pad1.08x0.95mm_HandSolder
D14, D15, D16, D19, D20, D21: SD15_SOD323; D_SOD-323
D17, D18: D_Schottky; D_2114_3652Metric
J2: USB4105-GF-A; GCT_USB4105-GF-A; PARTREV A3
Q1, Q2: BC817; SOT-23
R5: 22.1k; R_0603_1608Metric
R7: 47.5k; R_0603_1608Metric
R8, R10, R11, R25: 10k; R_0603_1608Metric
R9: 1k; R_0603_1608Metric
R22, R23, R26, R27: 5.1k; C_0805_2012Metric
U3: CP2102N-A01-GQFN24; QFN-24-1EP_4x4mm_P0.5mm_EP2.6x2.6mm

Connections:
+3.3V: C6.1, R9.2, R25.2, U3.5 (VIO), U3.6 (VDD), U3.7 (REGIN)
DTR: Q2.3 (C)
GND: C3.2, C4.2, C5.2, C6.2, C20.2, D14.2 (A2), D15.2 (A2), D16.2 (A2), D19.2 (A2), D20.2 (A2), D21.2 (A2), J2.A1_B12 (GND), J2.B1_A12 (GND), J2.S1 (SHELL_GND), J2.S2 (SHELL_GND), J2.S3 (SHELL_GND), J2.S4 (SHELL_GND), R7.2, R8.2, R22.2, R23.2, R26.2, R27.2, U3.2 (GND), U3.25 (GND)
unnamed: C5.1, R5.2, R7.1, U3.8 (VBUS)
unnamed: D17.2 (A), J2.A4_B9 (VBUS), J2.B4_A9 (VBUS)
unnamed: J2.A5 (CC1), R22.1, R23.1
unnamed: J2.B5 (CC2), R26.1, R27.1
unnamed: Q1.1 (B), R10.1
unnamed: Q1.2 (E), R11.2, U3.19 (RTS)
unnamed: Q2.1 (B), R11.1
unnamed: Q2.2 (E), R10.2, U3.23 (DTR)
unnamed: R8.1, U3.15 (~SUSPENDb)
unnamed: R9.1, U3.9 (~RSTb)
RTS: C20.1, Q1.3 (C), R25.1
UART_RX: U3.20 (RXD)
UART_TX: U3.21 (TXD)
USB-C_OTG_5V: C3.1, D14.1 (A1), D17.1 (K)
USB-C_OTG_D+: D15.1 (A1), J2.A6 (DP1), J2.B6 (DP2)
USB-C_OTG_D-: D16.1 (A1), J2.A7 (DN1), J2.B7 (DN2)
USB-C_UART_5V: C4.1, D18.1 (K), D20.1 (A1)
USB-C_UART_D+: D19.1 (A1), J2.A6 (DP1), J2.B6 (DP2), U3.3 (D+)
USB-C_UART_D-: D21.1 (A1), J2.A7 (DN1), J2.B7 (DN2), U3.4 (D-)
USB-C_UART_VBUS: D18.2 (A), J2.A4_B9 (VBUS), J2.B4_A9 (VBUS), R5.1

Notes on the sheet:
USB-UART converter
USB-C (OTG)
USB-C (UART)
