TheZlodziej/keypad-board/(commit log)

2023-11-13 add btn matrix & led strip
    [button-matrix.kicad_sch, keypad.kicad_sch, untitled.kicad_sch]
2023-11-14 add usb-c interface
    [button-led-strip.kicad_sch, keypad.kicad_sch, usb-c-interface.kicad_sch]
2023-11-14 battery source
    [keypad.kicad_sch, usb-c-interface.kicad_sch]
2023-11-14 rest of the schematic
    [button-led-strip.kicad_sch, button-matrix.kicad_sch, io.kicad_sch, keypad.kicad_sch, micro-sd-connector.kicad_sch, power-source.kicad_sch, usb-c-interface.kicad_sch]
2023-11-14 keypad update
    [button-matrix.kicad_sch, keypad.kicad_sch]
2023-11-18 add all footprints & move libs to project specific
    [io.kicad_sch, keypad.kicad_sch, micro-sd-connector.kicad_sch, power-source.kicad_sch, usb-c-interface.kicad_sch]
2023-11-18 move fet footprint to local lib & init pcb deisgn
    [keypad.kicad_pcb]
2023-11-20 inital pcb layout
    [io.kicad_sch, keypad.kicad_pcb, untitled.kicad_sch]
2023-11-20 pcb layout update
    [io.kicad_sch, keypad.kicad_pcb]
2023-11-21 full inital pcb layout
    [keypad.kicad_pcb]
2023-11-21 update keys alignment
    [keypad.kicad_pcb]
2023-11-21 main layout
    [freerouting.dsn, io.kicad_sch, keypad.kicad_pcb, keypad.kicad_sch, keypad_cutout.dxf, micro-sd-connector.kicad_sch, power-source.kicad_sch, usb-c-interface.kicad_sch]
2023-11-21 rm keypad 2ndary btns
    [button-matrix.kicad_sch, keypad.kicad_pcb]
2023-11-22 assigned different pins so it's easier for the layout
    [keypad.kicad_pcb, keypad.kicad_sch, usb-c-interface.kicad_sch]
2023-11-23 layout update
    [io.kicad_sch, keypad.kicad_pcb, keypad.kicad_sch]
2023-11-23 move libs to this repo
    [BMM150_BGA_array.ods, EDI2CAP.CFG, MAX-M10S-00B.stp, chips.prt, keypad_cutout.dxf, maxm10s00b.psm]
2023-11-23 move kicad libs to project & add relative paths
    [keypad_cutout.dxf]
2023-11-23 update layout
    [keypad.kicad_pcb]
2023-11-23 finish routing
    [keypad-cutout.dxf, keypad.kicad_pcb]
2023-11-23 new cutout + 3d models
    [Bourns_-_PEC11R-4220F-S0024.step, Buzzer_5V.STEP, EC12 Encoder 10mm 3pin.stp, ESP32-S3-WROOM.step, Pantalla OLED 0.96'' 128x64.stp, USB Type C Port (SMD Type).STEP, Vertical slide switch SS-12D00G3 High Knob 3mm SPDT v2.step, asm_mx_asm_PLATE.stp]
2023-11-23 micro sd slot mirror
2023-11-24 small improvements & different connection in power button
    [power-source.kicad_sch]
2023-11-25 ldo adjustments
    [power-source.kicad_sch]
2023-11-25 remove encoder ref number from silkscreen
2023-11-25 prepare for production
    [button-led-strip.kicad_sch, button-matrix.kicad_sch, freerouting.dsn, io.kicad_sch, keypad.kicad_sch, micro-sd-connector.kicad_sch, power-source.kicad_sch, usb-c-interface.kicad_sch]
2023-11-26 ipt file for cutout
    [keypad-cutout.ipt]
2023-11-26 add battery charging circuit
    [power-source.kicad_sch]
2023-11-26 finish charging circuit, add description in front silk screen, prepare for production
    [power-source.kicad_sch]
2023-12-01 update datasheets
    [button-led-strip.kicad_sch, button-matrix.kicad_sch, io.kicad_sch, micro-sd-connector.kicad_sch, power-source.kicad_sch, usb-c-interface.kicad_sch]
2023-12-14 cleanup repo, add production files and bom
    [BMM150_BGA_array.ods, Bourns_-_PEC11R-4220F-S0024.step, Buzzer_5V.STEP, EC12 Encoder 10mm 3pin.stp, EDI2CAP.CFG, ESP32-S3-WROOM.step, MAX-M10S-00B.stp, Pantalla OLED 0.96'' 128x64.stp]
2023-12-18 update project
    [bom.csv, bom.xlsx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]
2023-12-29 correct schematic
    [button-matrix.kicad_sch, io.kicad_sch, keypad.kicad_sch, power-source.kicad_sch, usb-c-interface.kicad_sch]
2024-01-02 fix board, update production files
    [bom.csv, bom.xlsx, io.kicad_sch, keypad.kicad_sch, micro-sd-connector.kicad_sch, power-source.kicad_sch, usb-c-interface.kicad_sch]
2024-01-02 update schematic
    [io.kicad_sch, power-source.kicad_sch]
2024-01-05 add cover file
    [keypad-cover.ipt]
2024-01-06 update cover project
    [keypad-cover.ipt]
2024-01-06 update 3d model
    [keypad-cover.ipt]
2024-01-06 cover adjustments
    [keypad-cover.ipt]
2024-01-08 update BOM
    [bom.csv, bom.xlsx]
2024-01-11 top cover v1
    [keypad-cover.ipt]
2024-01-20 update code according to new board
    [configuration.h]
